arananet/TF-HARDWARE/README.md

# TF-HARDWARE
A backup (04-04-2017) of the last TF repo that includes the projects (TF520,TF530,A3640 & breakout). All the work belongs to Stephen Leary, I just share the files as a repo backup.
