arananet/TF-HARDWARE/tf530/README.md

# TF530

** WARNING THIS IS BETA AT THE MOMENT

This repository contains all the files needed to produce a copy of my accelerator board.

The CPLD Required is a XC9572XL-10VQ64

Everything in this repository is released under the GNU GPLv2. You may create or base commercial PCBs from the work in this repository but you must make the sources for all derivative work available. 

## Firmware / Requirements

  * Xilinx ISE, 14.7 (the final version - other versions may work but this is the one I support)
  * JTAG Adaptor

[For more information visit my channel](https://www.youtube.com/c/TerribleFire)

##License

This project and all the files contained are released under the GNU GPLv2. If you build a modified version of the board you must supply the end user with all the sources (this can be a web link).

##The TerribleFire 530 board (Revision 2)

This board is now in Beta. It may not work in all circumstances but it has been verified to boot AmigaOS 1.3, 2.05 and 3.1 and run various games and desktop apps at 25Mhz. Operation is not guarunteed to be crash free but will work in most "happy path" situations.

I have only verified the HD interface with Compact Flash cards.
I have verified this board boots on Amiga 500 Rev 5, 6a, 8.1a

Revision 3: 

Completely untested board link.... use with caution!!!! Do not come crying to me if it didnt work!!

http://dirtypcbs.com/store/designer/details/12476/2654/tf530-rev3-zip

Revision 2:

To buy 10 blank copies of the revision 2 board follow the following link.

http://dirtypcbs.com/store/designer/details/12476/1330/tf530-rev2b-zip

(Terrible Fire gets a $2 "cut" for each order... in reality this is a downpayment on future prototype board orders).

I accept no responsibiltiy for any damage to any equipment that results from the use of this board. IT IS ENTIRELY AT YOUR OWN RISK!

## Installation

Installation is exactly the same as the Kipper2k A508. Refer to http://www.kipper2k.com/a500fastmem.html

You need to connect the OVR and INT2 signals to the A500 header port. 

## Take this image as example connection

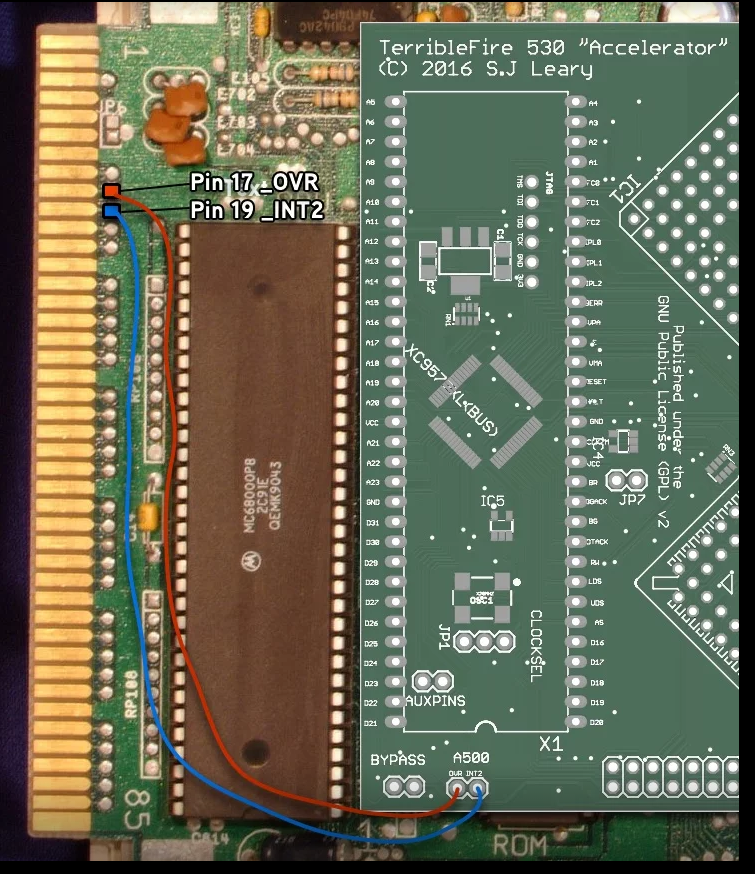
[picture p1: tf530/gerbers/conexion.png]
Connection


## What does the board look like

Rev 3:

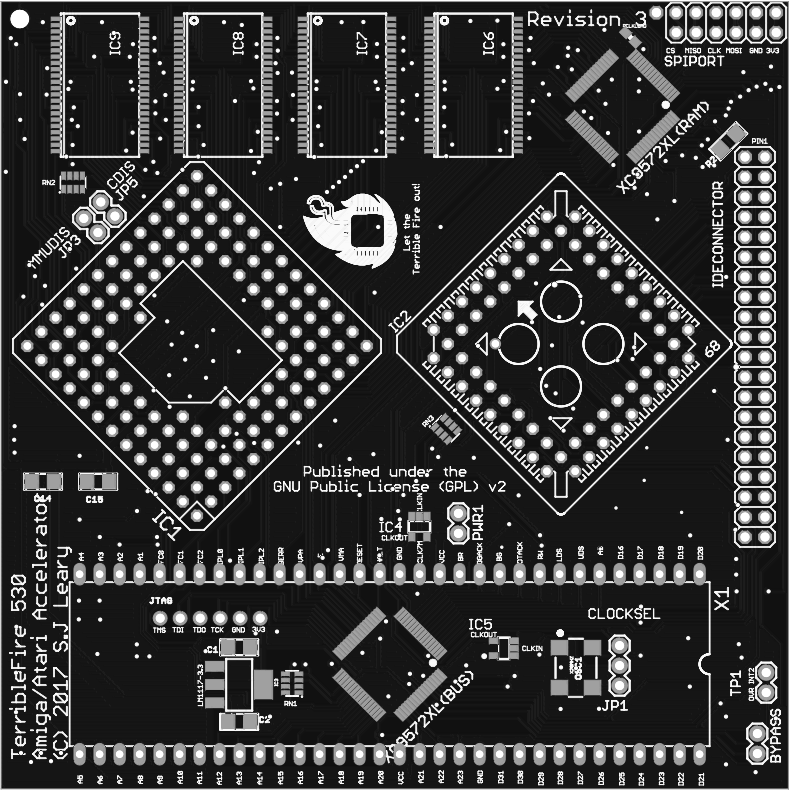
[picture p2: tf530/gerbers/tf530_rev3_top.png]


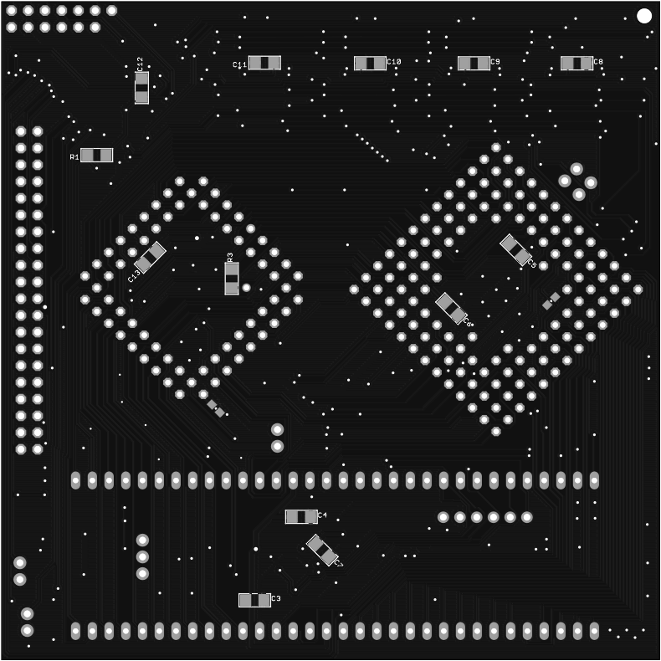
[picture p3: tf530/gerbers/tf530_rev3_bottom.png]
Image of Bottom of PCB


Rev 2:

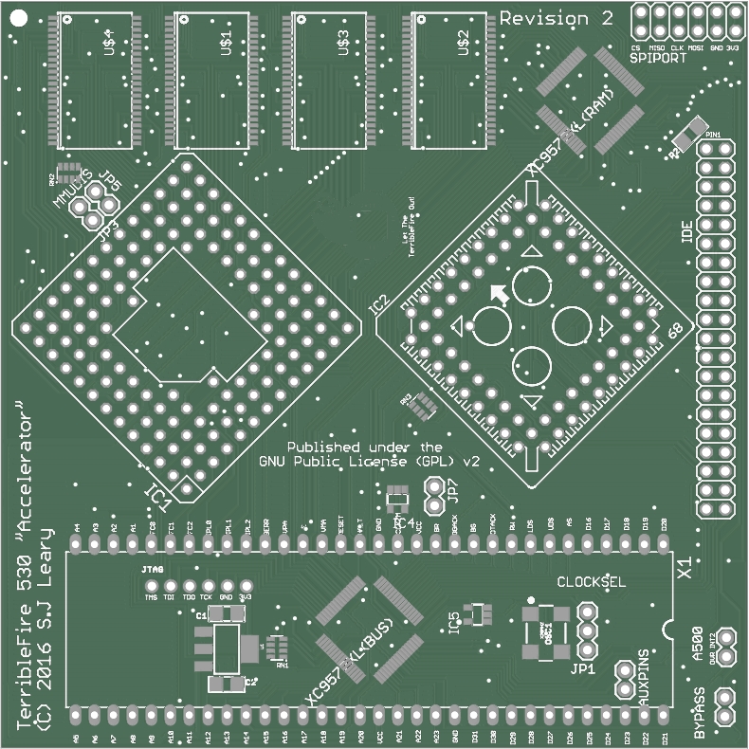
[picture p4: tf530/gerbers/tf530_rev2_top.jpg]


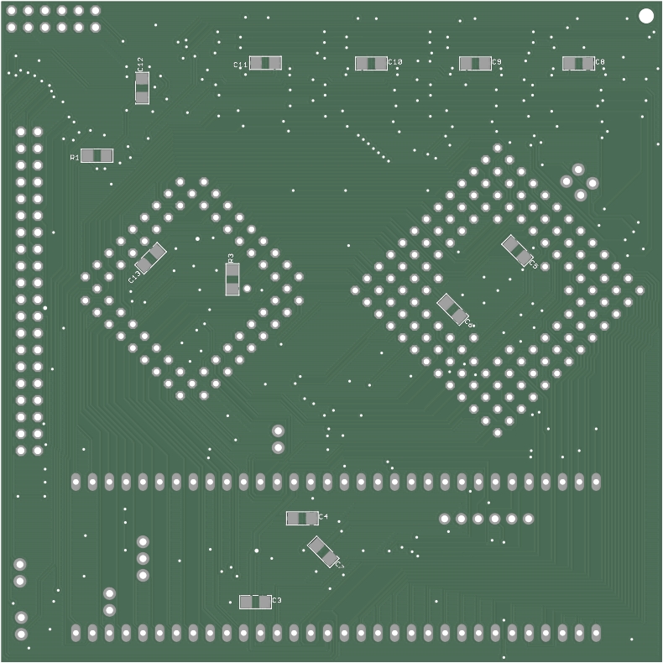
[picture p5: tf530/gerbers/tf530_rev2_bottom.jpg]
Image of Bottom of PCB


## The BOM 

| Qty | Value | Device | Package | Parts | Description | 
|-----|---|---|---|---|---|
| 1 | | MC68030RC | MPGA128 | IC1 | 68xxx PROCESSOR | 
| 1 | | MC68881FN-SOC | PLCC68-S | IC2 | 68xxx PROCESSOR |
| 1 | 10K | RESISTOR1206 | 1206 | R1, R2, R3 | Resistors |
| 13  | 10uF | CAP_CERAMIC1206 | 1206 | C1, C2, C3, C4, C5, C6, C7, C8, C9, C10, C11, C12, C13 | Ceramic Capacitors | 
| 2 | 74LVC1G17DBV | 74LVC1G17DBV | SOT23-5 | IC4, IC5 | Single Schmitt-Trigger Buffer | 
| 1 | A500 | JUMPER-2PTH | 1X02 | A500 | Jumper | 
| 4 | AS7C4096A-12TIN | AS7C4096A-12TCN | TSOP44-II | U$1, U$2, U$3, U$4 | |  
| 1 | AUXPINS | JUMPER-2PTH | 1X02 | AUXPINS | Jumper | 
| 1 | BYPASS | JUMPER-2PTH | 1X02 | BYPASS | Jumper (optional) | 
| 3 | CAY16-103J4LF | CAY16-103J4LF | RESCAXE80P320X160-8N | RN1, RN2, RN3 | Res Thick Film Array 10K Ohm  | 
| 1 | CDIS | JUMPER-2PTH | 1X02 | JP5 | Jumper |
| 1 | CLOCKSEL | JUMPER-3PTH | 1X03 | JP1 | | 
| 1 | EXT5V | JUMPER-2PTH | 1X02 | JP7 | Jumper |
| 1 | IDE CONNECTOR | PINHD-2X20 | 2X20 | IDE | PIN HEADER |
| 1 | JTAG | HEADER-1X6ROUND | 1X06_ROUND | JTAG | PIN HEADER |
| 1 | LM1117 | V_REG_LM1117SOT223 | SOT223 | U1 | 3.3V Voltage  Regulator LM1117 |
| 1 | MC68000 | MC68000P | DIL64 | X1 | 68xxx PROCESSOR SOCKET | 
| 1 | MMUDIS | JUMPER-2PTH | 1X02 | JP3 | Jumper | 
| 1 | SPI PORT | PINHD-2X6 | 2X06 | SPIPORT | PIN HEADER | 
| 1 | X24MHZ | OSCILLATOR | OSC_7X5MM | OSC1 | 24 Mhz llators |
| 2 | XC9572XL-10VQ64 | XC9572XL-VQ64 | VQ64 | XC9572XL(BUS), XC9572XL(RAM) | |
