arananet/TF-HARDWARE/breakout/68kshunt/README.md

# 68k Shunt

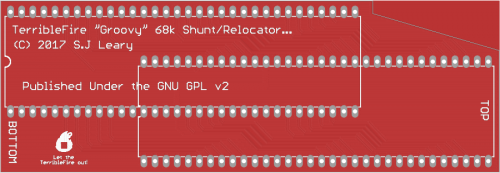
[picture p6: breakout/68kshunt/images/top.png]
Image of Top of PCB
