arananet/TF-HARDWARE/a3640/docs/68040_schematics/68040/68040_0002b.png

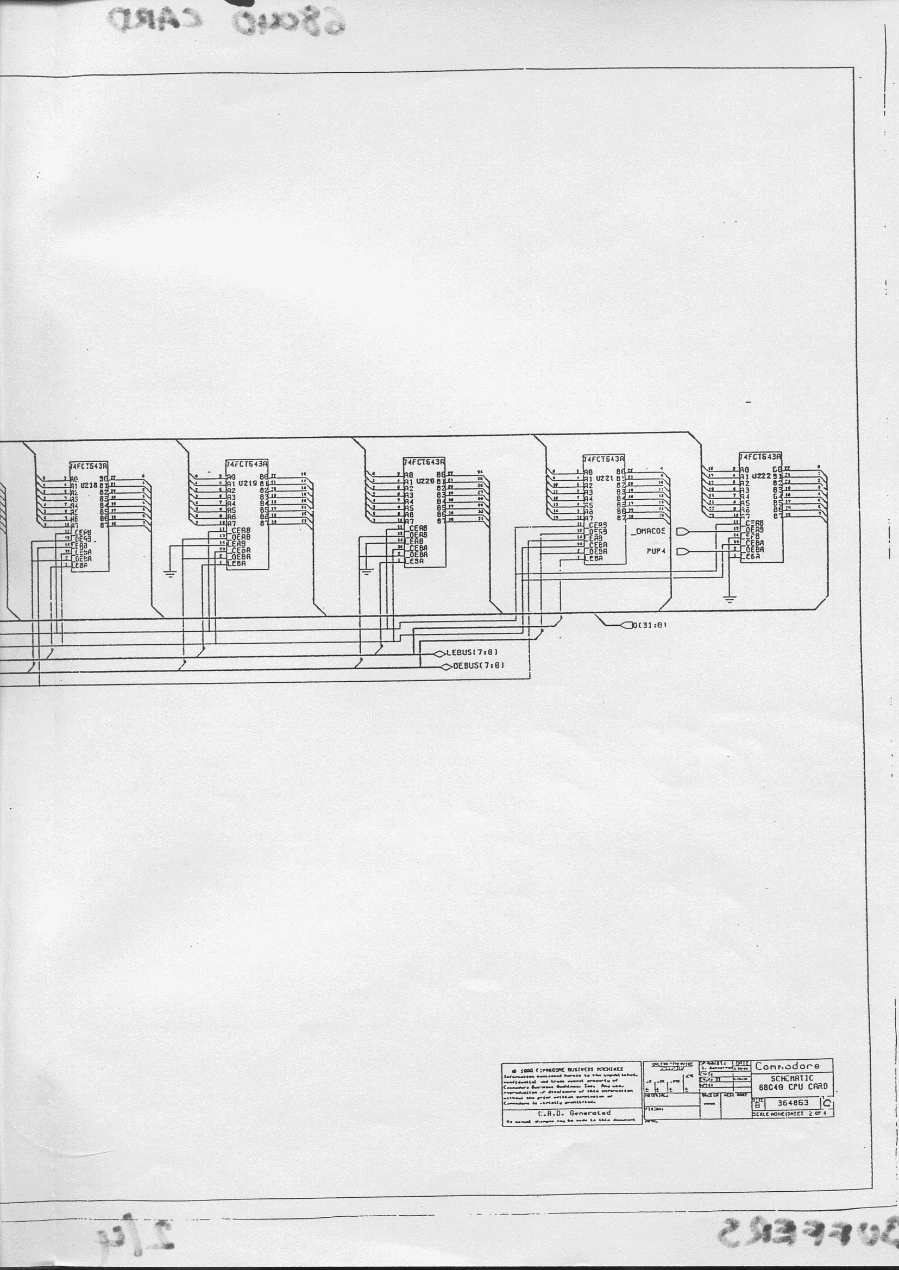
a3640/docs/68040_schematics/68040/68040_0002b.png
