arananet/TF-HARDWARE/breakout/68020/images/bottom.png

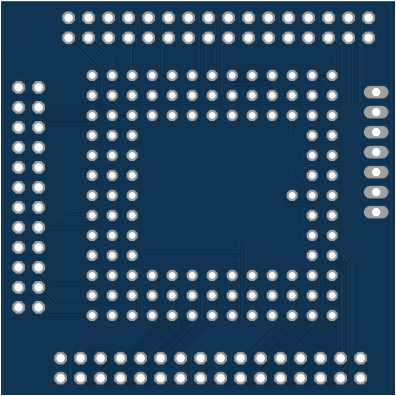
breakout/68020/images/bottom.png
