arananet/TF-HARDWARE/breakout/68020/images/top.png

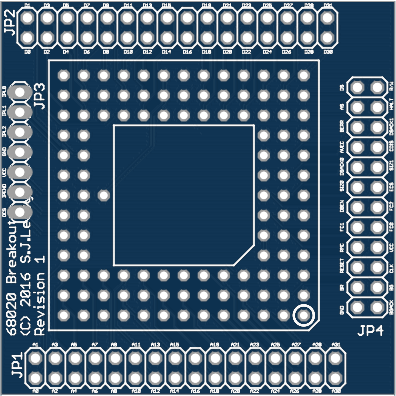
breakout/68020/images/top.png
