arananet/TF-HARDWARE/breakout/68030/images/bottom.png

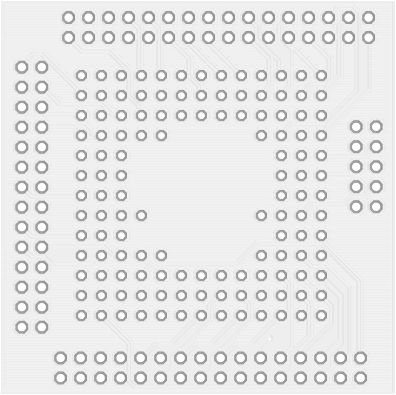
breakout/68030/images/bottom.png
