arananet/TF-HARDWARE/breakout/68030/images/top.png

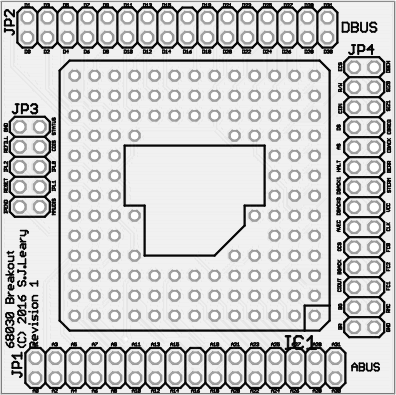
breakout/68030/images/top.png
