arananet/TF-HARDWARE/a3640/docs/a3640_bom.xlsx

Part | Value | Form | Pcb location | Qty. | Mouser | RS | FARNELL | Rocherster | Others
CAPACITOR,SM,X7R | 10nF | 1206 | C100A, | 1 | C1206C103JARACTU
CAPACITOR,SM,Ceramic | 100nF | 1206 | C101A,C103A,C104A,C105A,C200A,C2 01A,C202A,C203A,C204,C205, C206A,C207,C208A,C209,C211, C213,C400A,C401A,C402A, | 19 | C1206C104J5JACTU
CAPACITOR,SM,Z5U | 330nF | 1210 | C101B,C212A,C214A,C215A,C216A,C2 17A,C218A,C219A,C220A,C221A,C222 A, | 11 | C1210C334J3JACTU
CAPACITOR,SM,Z5U | 220nF | 1210 | C102A,C102D, | 2 | C1210C224J3JACTU
CAPACITOR,SM,NPO | 220PF | 1206 | C102C,C102F, | 2 | C1206C221KDRACTU
Cond. ELECTROLYTIC | 22UF | C /16V | C102B,C102E,C105,C106,C107, | 5 | EEH-ZA1V220R
Filter, Ferrit, SMT | 80 Ohm @100Mhz, 500mA | 1812 | FB100,FB200, | 2 | BLM41AF800SN1L
RES Chip, 1/8W, 5% | 1 | 1206 | R100,R103, | 2 | KTR18EZPF1R00
RES Chip, 1/8W, 5% | 22 | 1206 | R101,R102, | 2 | RK73H2BRTTD22R0F
RES Chip, 1/8W, 5% | 33 | 1206 | R107,R108, | 2 | RK73H2BRTTD33R0F
RES Chip, 1/8W, 5% | 100 | 1206 | R401, | 1 | KTR18EZPF1000
RES Chip, 1/8W, 5% | 470 | 1206 | R402,R403,R404, | 3 | KTR18EZPF4700
RES Chip, 1/8W, 5% | 4.7K | 1206 | R104,R105,R106,R405, | 4 | KTR18EZPF4701
RES Chip, 1/8W, 5% | 10K | 1206 | R400, | 1 | KTR18EZPF1002
RPK10 Array 9x | 1K | SIL10 | RP100,RP400,RP401,RP402,RP403,R P404,RP405, | 7 | 4609M-101-102LF
RPK8 Array 4x | 22 | SIL8 | RP101,RP102,RP103,RP104,RP105,R P106,RP107,RP108, | 8 | 4608X-102-220LF
74FCT244AT |  | SO-20 | U402, | 1 | CY74FCT244ATSOC
74FCT374AT |  | SO-20 | U201, | 1 | CY74FCT374ATSOCT
74FCT373AT |  | SO-20 | U200, | 1 | 74FCT373ATSOG
74F32 |  | SO-14 | U202, | 1 | SN74F32D
74F257 |  | SO-16 | U212, | 1 | SN74F257D
74F139 |  | SO-16 | U206, | 1 | 74F139SC
74F04 |  | SO-14 | U105, | 1 | SN74F04DR
7407 |  | SO-14 | U104, | 1 | SN7407DR
74FCT543T |  | SO-24 | U214,U215,U216,U217,U218,U219,U22 0,U221,U222, | 9 | CY74FCT543TSOCT
74F1803 | Clock divider | SO-14 | U101, | 1 |  |  |  |  | Maybe rework circuit
RH5VA43A VoltageDetector |  | SOT-89 | U490, Rework on C400, | 1 | TC54VN2702EMB713
DELAYLINE 5 TAP ea 5ns | 25ns | DIP14 | U103, | 1 |  |  |  | MXD1000SA200
OSC | 50MHz | DIP14/4 | U100, | 1 | MXO45-3C-50M0000
SPJUMPER | SIL 3 |  | J400, | 1
SPJUMPER | SIL 4 |  | J100, | 1
SPJUMPER | SIL 2 |  | TJ100, | 1
Shorting Bars (Shunts) |  |  | 2xJ100,J400,TJ100, | 4
BUS CONNECTOR KEL 817-200-170S-F |  |  | CN100, | 1 |  |  |  |  | Internet
Socket, CPU | 179pin | PGA | U102, | 1 | 510-93-179-18-095002
Head Sink and Clip |  | 47x47 | U102, | 1
MC68040 |  |  | U102, | 1 |  |  |  |  | Internet
GAL 22V10-15 | taxlat | PLCC28 | U213, | 1 | ATF22V10C-15JU(maybe)
GAL 22V10-15 | oebus | PLCC28 | U207, | 1 | ATF22V10C-15JU(maybe)
GAL 22V10-15 | mapper | PLCC28 | U400, | 1 | ATF22V10C-15JU(maybe)
GAL 22V10-10 | buscon | PLCC28 | U204, | 1 | ATF22V10C-15JU(maybe)
GAL 22V10-10 | busterm | PLCC28 | U205, | 1 | ATF22V10C-15JU(maybe)
GAL 22V10-10 | bctl | PLCC28 | U209, | 1 | ATF22V10C-15JU(maybe)
GAL 22V10-10 | start | PLCC28 | U211, | 1 | ATF22V10C-15JU(maybe)
GAL16V8-10 | term | PLCC20 | U203, | 1 | ATF16V8B-10JU(maybe)
GAL16V8-10 | lebus | PLCC20 | U208, | 1 | ATF16V8B-10JU(maybe)
GAL16V8-10 | rst | PLCC20 | U401, | 1 | ATF16V8B-10JU(maybe)
