arananet/TF-HARDWARE/tf530/eagle/SL530.brd

## EAGLE design tf530/eagle/SL530.brd (2017-04-26)

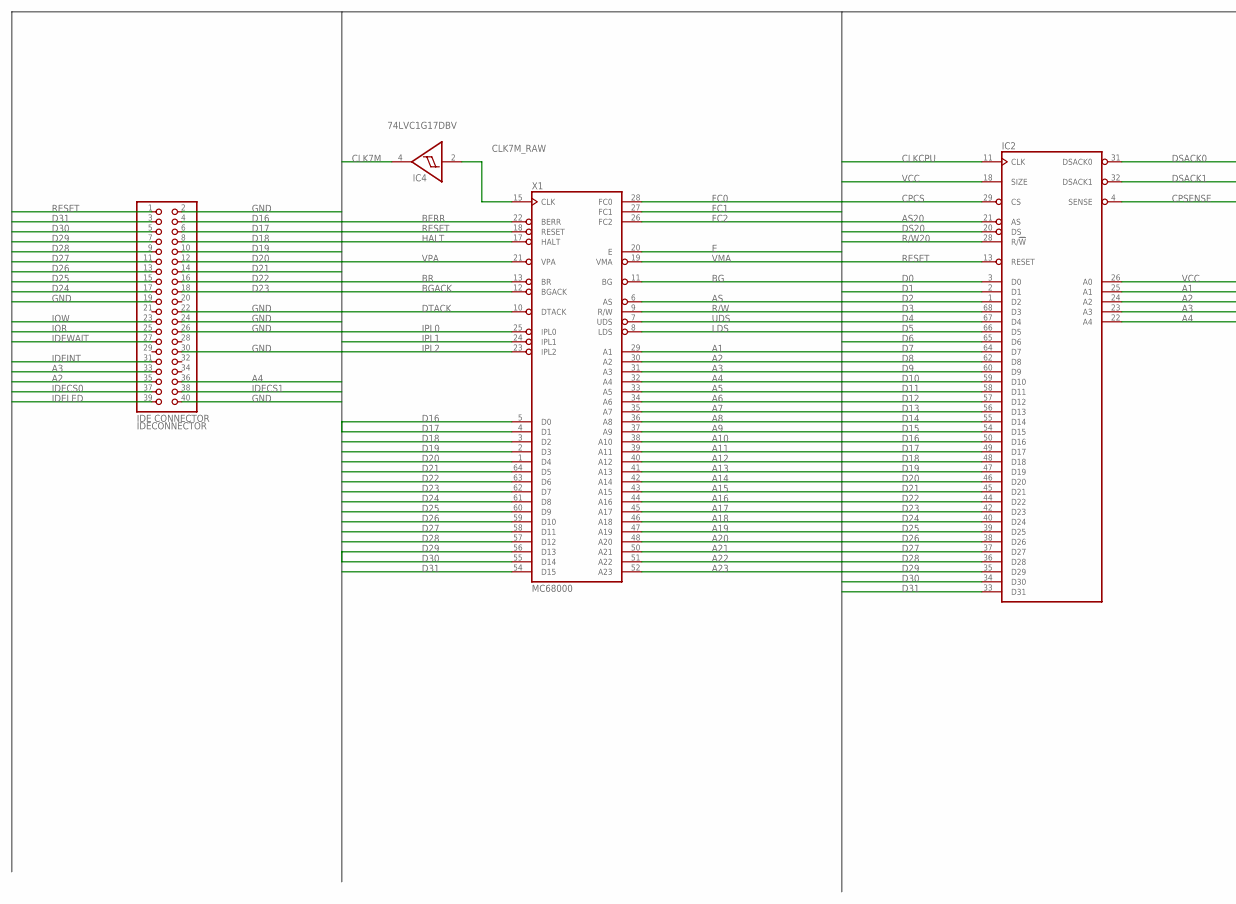
[picture p21: schematic SL530.sch, sheet 1, part in row 1, column 1]

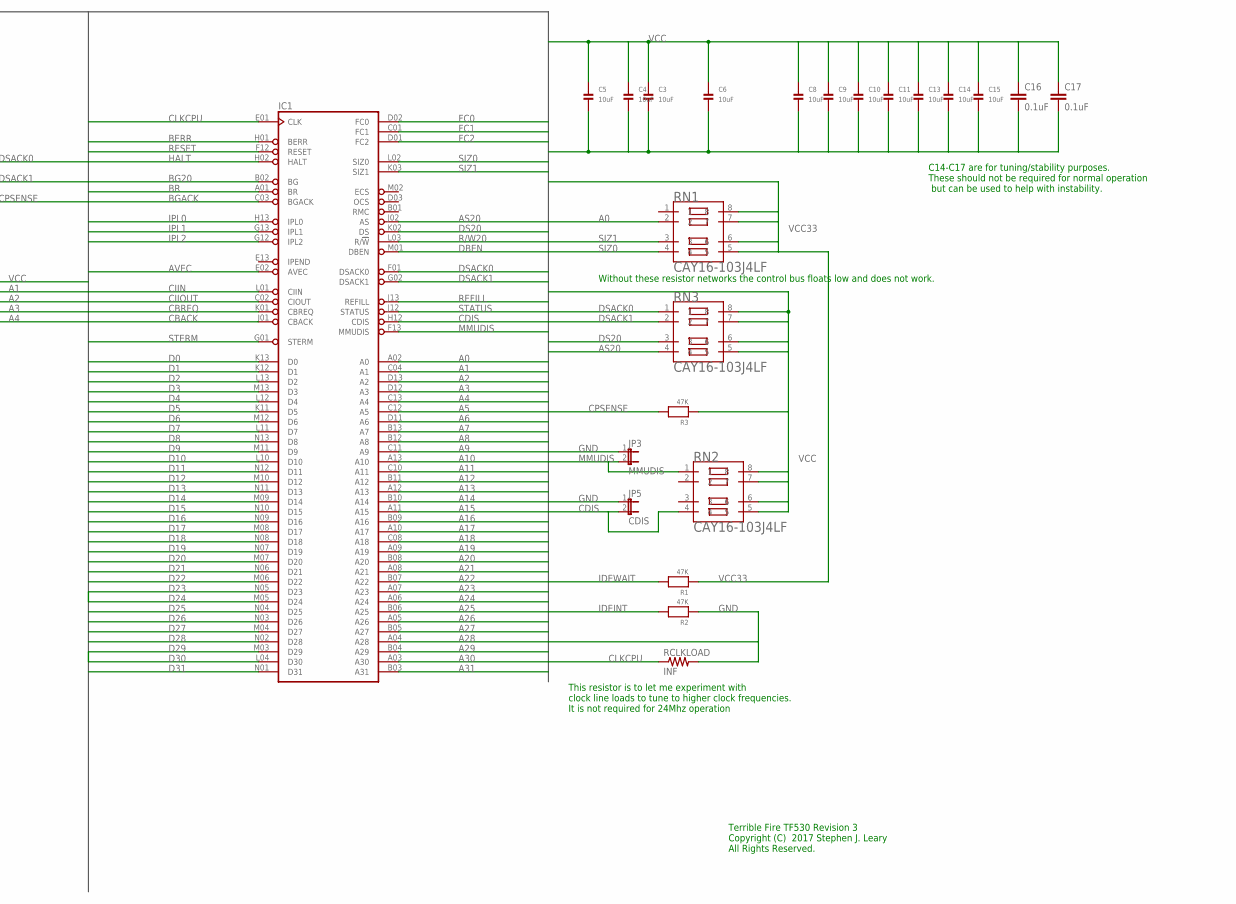
[picture p22: schematic SL530.sch, sheet 1, part in row 1, column 2]

Parts:
C3, C4, C5, C6, C8, C9, C10, C11, C13, C14, C15: 10uF; 1206
C16, C17: 0.1uF; 0603-CAP
IC1: MC68030RC; MPGA128
IC2: MC68881FN-SOC; PLCC68-S
IC4: 74LVC1G17DBV; SOT23-5
IDECONNECTOR: IDE CONNECTOR; 2X20
JP3: MMUDIS; 1X02
JP5: CDIS; 1X02
R1, R2, R3: 47K; 1206
RCLKLOAD: INF; 0603
RN1, RN2, RN3: CAY16-103J4LF; RESCAXE80P320X160-8N
X1: MC68000; DIL64

Connections:
A0: IC1.A02 (A0), RN1.2; also elsewhere on the board
A1: IC1.C04 (A1), IC2.25 (A1), X1.29 (A1); also elsewhere on the board
A2: IC1.D13 (A2), IC2.24 (A2), IDECONNECTOR.35, X1.30 (A2); also elsewhere on the board
A3: IC1.D12 (A3), IC2.23 (A3), IDECONNECTOR.33, X1.31 (A3); also elsewhere on the board
A4: IC1.C13 (A4), IC2.22 (A4), IDECONNECTOR.36, X1.32 (A4); also elsewhere on the board
A5: IC1.C12 (A5), X1.33 (A5); also elsewhere on the board
A6: IC1.D11 (A6), X1.34 (A6); also elsewhere on the board
A7: IC1.B13 (A7), X1.35 (A7); also elsewhere on the board
A8: IC1.B12 (A8), X1.36 (A8); also elsewhere on the board
A9: IC1.C11 (A9), X1.37 (A9); also elsewhere on the board
A10: IC1.A13 (A10), X1.38 (A10); also elsewhere on the board
A11: IC1.C10 (A11), X1.39 (A11); also elsewhere on the board
A12: IC1.B11 (A12), X1.40 (A12); also elsewhere on the board
A13: IC1.A12 (A13), X1.41 (A13); also elsewhere on the board
A14: IC1.B10 (A14), X1.42 (A14); also elsewhere on the board
A15: IC1.A11 (A15), X1.43 (A15); also elsewhere on the board
A16: IC1.B09 (A16), X1.44 (A16); also elsewhere on the board
A17: IC1.A10 (A17), X1.45 (A17); also elsewhere on the board
A18: IC1.C08 (A18), X1.46 (A18); also elsewhere on the board
A19: IC1.A09 (A19), X1.47 (A19); also elsewhere on the board
A20: IC1.B08 (A20), X1.48 (A20); also elsewhere on the board
A21: IC1.A08 (A21), X1.50 (A21); also elsewhere on the board
A22: IC1.B07 (A22), X1.51 (A22); also elsewhere on the board
A23: IC1.A07 (A23), X1.52 (A23); also elsewhere on the board
A24: IC1.A06 (A24)
A25: IC1.B06 (A25)
A26: IC1.A05 (A26)
A27: IC1.B05 (A27)
A28: IC1.A04 (A28)
A29: IC1.B04 (A29)
A30: IC1.A03 (A30)
A31: IC1.B03 (A31)
AS: X1.6 (AS); also elsewhere on the board
AS20: IC1.J02 (AS), IC2.21 (AS), RN3.4; also elsewhere on the board
AVEC: IC1.E02 (AVEC); also elsewhere on the board
BERR: IC1.H01 (BERR), X1.22 (BERR); also elsewhere on the board
BG: X1.11 (BG); also elsewhere on the board
BG20: IC1.B02 (BG); also elsewhere on the board
BGACK: IC1.C03 (BGACK), X1.12 (BGACK); also elsewhere on the board
BR: IC1.A01 (BR), X1.13 (BR)
CBACK: IC1.J01 (CBACK); also elsewhere on the board
CBREQ: IC1.K01 (CBREQ); also elsewhere on the board
CDIS: IC1.H12 (CDIS), JP5.2, RN2.4
CIIN: IC1.L01 (CIIN); also elsewhere on the board
CIIOUT: IC1.C02 (CIOUT)
CLK7M: IC4.4 (O); also elsewhere on the board
CLK7M_RAW: IC4.2 (I), X1.15 (CLK)
CLKCPU: IC1.E01 (CLK), IC2.11 (CLK), RCLKLOAD.1; also elsewhere on the board
CPCS: IC2.29 (CS); also elsewhere on the board
CPSENSE: IC2.4 (SENSE), R3.2; also elsewhere on the board
D0: IC1.K13 (D0), IC2.3 (D0); also elsewhere on the board
D1: IC1.K12 (D1), IC2.2 (D1); also elsewhere on the board
D2: IC1.L13 (D2), IC2.1 (D2); also elsewhere on the board
D3: IC1.M13 (D3), IC2.68 (D3); also elsewhere on the board
D4: IC1.L12 (D4), IC2.67 (D4); also elsewhere on the board
D5: IC1.K11 (D5), IC2.66 (D5); also elsewhere on the board
D6: IC1.M12 (D6), IC2.65 (D6); also elsewhere on the board
D7: IC1.L11 (D7), IC2.64 (D7); also elsewhere on the board
D8: IC1.N13 (D8), IC2.62 (D8); also elsewhere on the board
D9: IC1.M11 (D9), IC2.60 (D9); also elsewhere on the board
D10: IC1.L10 (D10), IC2.59 (D10); also elsewhere on the board
D11: IC1.N12 (D11), IC2.58 (D11); also elsewhere on the board
D12: IC1.M10 (D12), IC2.57 (D12); also elsewhere on the board
D13: IC1.N11 (D13), IC2.56 (D13); also elsewhere on the board
D14: IC1.M09 (D14), IC2.55 (D14); also elsewhere on the board
D15: IC1.N10 (D15), IC2.54 (D15); also elsewhere on the board
D16: IC1.N09 (D16), IC2.50 (D16), IDECONNECTOR.4, X1.5 (D0); also elsewhere on the board
D17: IC1.M08 (D17), IC2.49 (D17), IDECONNECTOR.6, X1.4 (D1); also elsewhere on the board
D18: IC1.N08 (D18), IC2.48 (D18), IDECONNECTOR.8, X1.3 (D2); also elsewhere on the board
D19: IC1.N07 (D19), IC2.47 (D19), IDECONNECTOR.10, X1.2 (D3); also elsewhere on the board
D20: IC1.M07 (D20), IC2.46 (D20), IDECONNECTOR.12, X1.1 (D4); also elsewhere on the board
D21: IC1.N06 (D21), IC2.45 (D21), IDECONNECTOR.14, X1.64 (D5); also elsewhere on the board
D22: IC1.M06 (D22), IC2.44 (D22), IDECONNECTOR.16, X1.63 (D6); also elsewhere on the board
D23: IC1.N05 (D23), IC2.42 (D23), IDECONNECTOR.18, X1.62 (D7); also elsewhere on the board
D24: IC1.M05 (D24), IC2.40 (D24), IDECONNECTOR.17, X1.61 (D8); also elsewhere on the board
D25: IC1.N04 (D25), IC2.39 (D25), IDECONNECTOR.15, X1.60 (D9); also elsewhere on the board
D26: IC1.N03 (D26), IC2.38 (D26), IDECONNECTOR.13, X1.59 (D10); also elsewhere on the board
D27: IC1.M04 (D27), IC2.37 (D27), IDECONNECTOR.11, X1.58 (D11); also elsewhere on the board
D28: IC1.N02 (D28), IC2.36 (D28), IDECONNECTOR.9, X1.57 (D12); also elsewhere on the board
D29: IC1.M03 (D29), IC2.35 (D29), IDECONNECTOR.7, X1.56 (D13); also elsewhere on the board
D30: IC1.L04 (D30), IC2.34 (D30), IDECONNECTOR.5, X1.55 (D14); also elsewhere on the board
D31: IC1.N01 (D31), IC2.33 (D31), IDECONNECTOR.3, X1.54 (D15); also elsewhere on the board
DBEN: IC1.M01 (DBEN)
DS20: IC1.K02 (DS), IC2.20 (DS), RN3.3; also elsewhere on the board
DSACK0: IC1.F01 (DSACK0), IC2.31 (DSACK0), RN3.1
DSACK1: IC1.G02 (DSACK1), IC2.32 (DSACK1), RN3.2; also elsewhere on the board
DTACK: X1.10 (DTACK); also elsewhere on the board
E: X1.20 (E); also elsewhere on the board
FC0: IC1.D02 (FC0), X1.28 (FC0); also elsewhere on the board
FC1: IC1.C01 (FC1), X1.27 (FC1); also elsewhere on the board
FC2: IC1.D01 (FC2), X1.26 (FC2); also elsewhere on the board
GND: C3.2, C4.2, C5.2, C6.2, C8.2, C9.2, C10.2, C11.2, C13.2, C14.2, C15.2, C16.2, C17.2, IC1.C05 (GND), IC1.C07 (GND), IC1.C09 (GND), IC1.E03 (GND), IC1.E11 (GND), IC1.F03 (GND), IC1.G03 (GND), IC1.G11 (GND), IC1.J03 (GND), IC1.J11 (GND), IC1.L05 (GND), IC1.L07 (GND), IC1.L08 (GND), IC1.L09 (GND), IC2.5 (GND), IC2.6 (GND), IC2.7 (GND), IC2.8 (GND), IC2.9 (GND), IC2.12 (GND), IC2.14 (GND), IC2.19 (GND), IC2.30 (GND), IC2.41 (GND), IC2.51 (GND), IC2.63 (GND), IC4.3 (GND), IDECONNECTOR.2, IDECONNECTOR.19, IDECONNECTOR.22, IDECONNECTOR.24, IDECONNECTOR.26, IDECONNECTOR.30, IDECONNECTOR.40, JP3.1, JP5.1, R2.1, RCLKLOAD.2, X1.16 (GND), X1.53 (GND); also elsewhere on the board
HALT: IC1.H02 (HALT), X1.17 (HALT); also elsewhere on the board
IDECS0: IDECONNECTOR.37; also elsewhere on the board
IDECS1: IDECONNECTOR.38; also elsewhere on the board
IDEINT: IDECONNECTOR.31, R2.2; also elsewhere on the board
IDELED: IDECONNECTOR.39
IDEWAIT: IDECONNECTOR.27, R1.2; also elsewhere on the board
IOR: IDECONNECTOR.25; also elsewhere on the board
IOW: IDECONNECTOR.23; also elsewhere on the board
IPL0: IC1.H13 (IPL0), X1.25 (IPL0)
IPL1: IC1.G13 (IPL1), X1.24 (IPL1); also elsewhere on the board
IPL2: IC1.G12 (IPL2), X1.23 (IPL2); also elsewhere on the board
LDS: X1.8 (LDS); also elsewhere on the board
MMUDIS: IC1.F13 (MMUDIS), JP3.2, RN2.1
R/W: X1.9 (R/W); also elsewhere on the board
R/W20: IC1.L03 (R/!W), IC2.28 (R/!W); also elsewhere on the board
REFILL: IC1.J13 (REFILL)
RESET: IC1.F12 (RESET), IC2.13 (RESET), IDECONNECTOR.1, X1.18 (RESET); also elsewhere on the board
SIZ0: IC1.L02 (SIZ0), RN1.4; also elsewhere on the board
SIZ1: IC1.K03 (SIZ1), RN1.3; also elsewhere on the board
STATUS: IC1.J12 (STATUS)
STERM: IC1.G01 (STERM); also elsewhere on the board
UDS: X1.7 (UDS); also elsewhere on the board
VCC: C3.1, C4.1, C5.1, C6.1, C8.1, C9.1, C10.1, C11.1, C13.1, C14.1, C15.1, C16.1, C17.1, IC1.C06 (VCC), IC1.D04 (VCC), IC1.D10 (VCC), IC1.F02 (VCC), IC1.F11 (VCC), IC1.H03 (VCC), IC1.H11 (VCC), IC1.K04 (VCC), IC1.K10 (VCC), IC1.L06 (VCC), IC2.10 (VCC), IC2.16 (VCC), IC2.17 (VCC), IC2.18 (SIZE), IC2.26 (A0), IC2.27 (VCC), IC2.43 (VCC), IC2.52 (VCC), IC2.53 (VCC), IC2.61 (VCC), IC4.5 (VCC), R3.1, RN2.5, RN2.6, RN2.7, RN2.8, RN3.5, RN3.6, RN3.7, RN3.8, X1.14 (VCC), X1.49 (VCC); also elsewhere on the board
VCC33: R1.1, RN1.5, RN1.6, RN1.7, RN1.8; also elsewhere on the board
VMA: X1.19 (VMA); also elsewhere on the board
VPA: X1.21 (VPA); also elsewhere on the board

Notes on the sheet:
This resistor is to let me experiment with clock line loads to tune to higher clock frequencies. It is not required for 24Mhz operation
C14-C17 are for tuning/stability purposes. These should not be required for normal operation but can be used to help with instability.
Without these resistor networks the control bus floats low and does not work.
Terrible Fire TF530 Revision 3 Copyright (C) 2017 Stephen J. Leary All Rights Reserved.

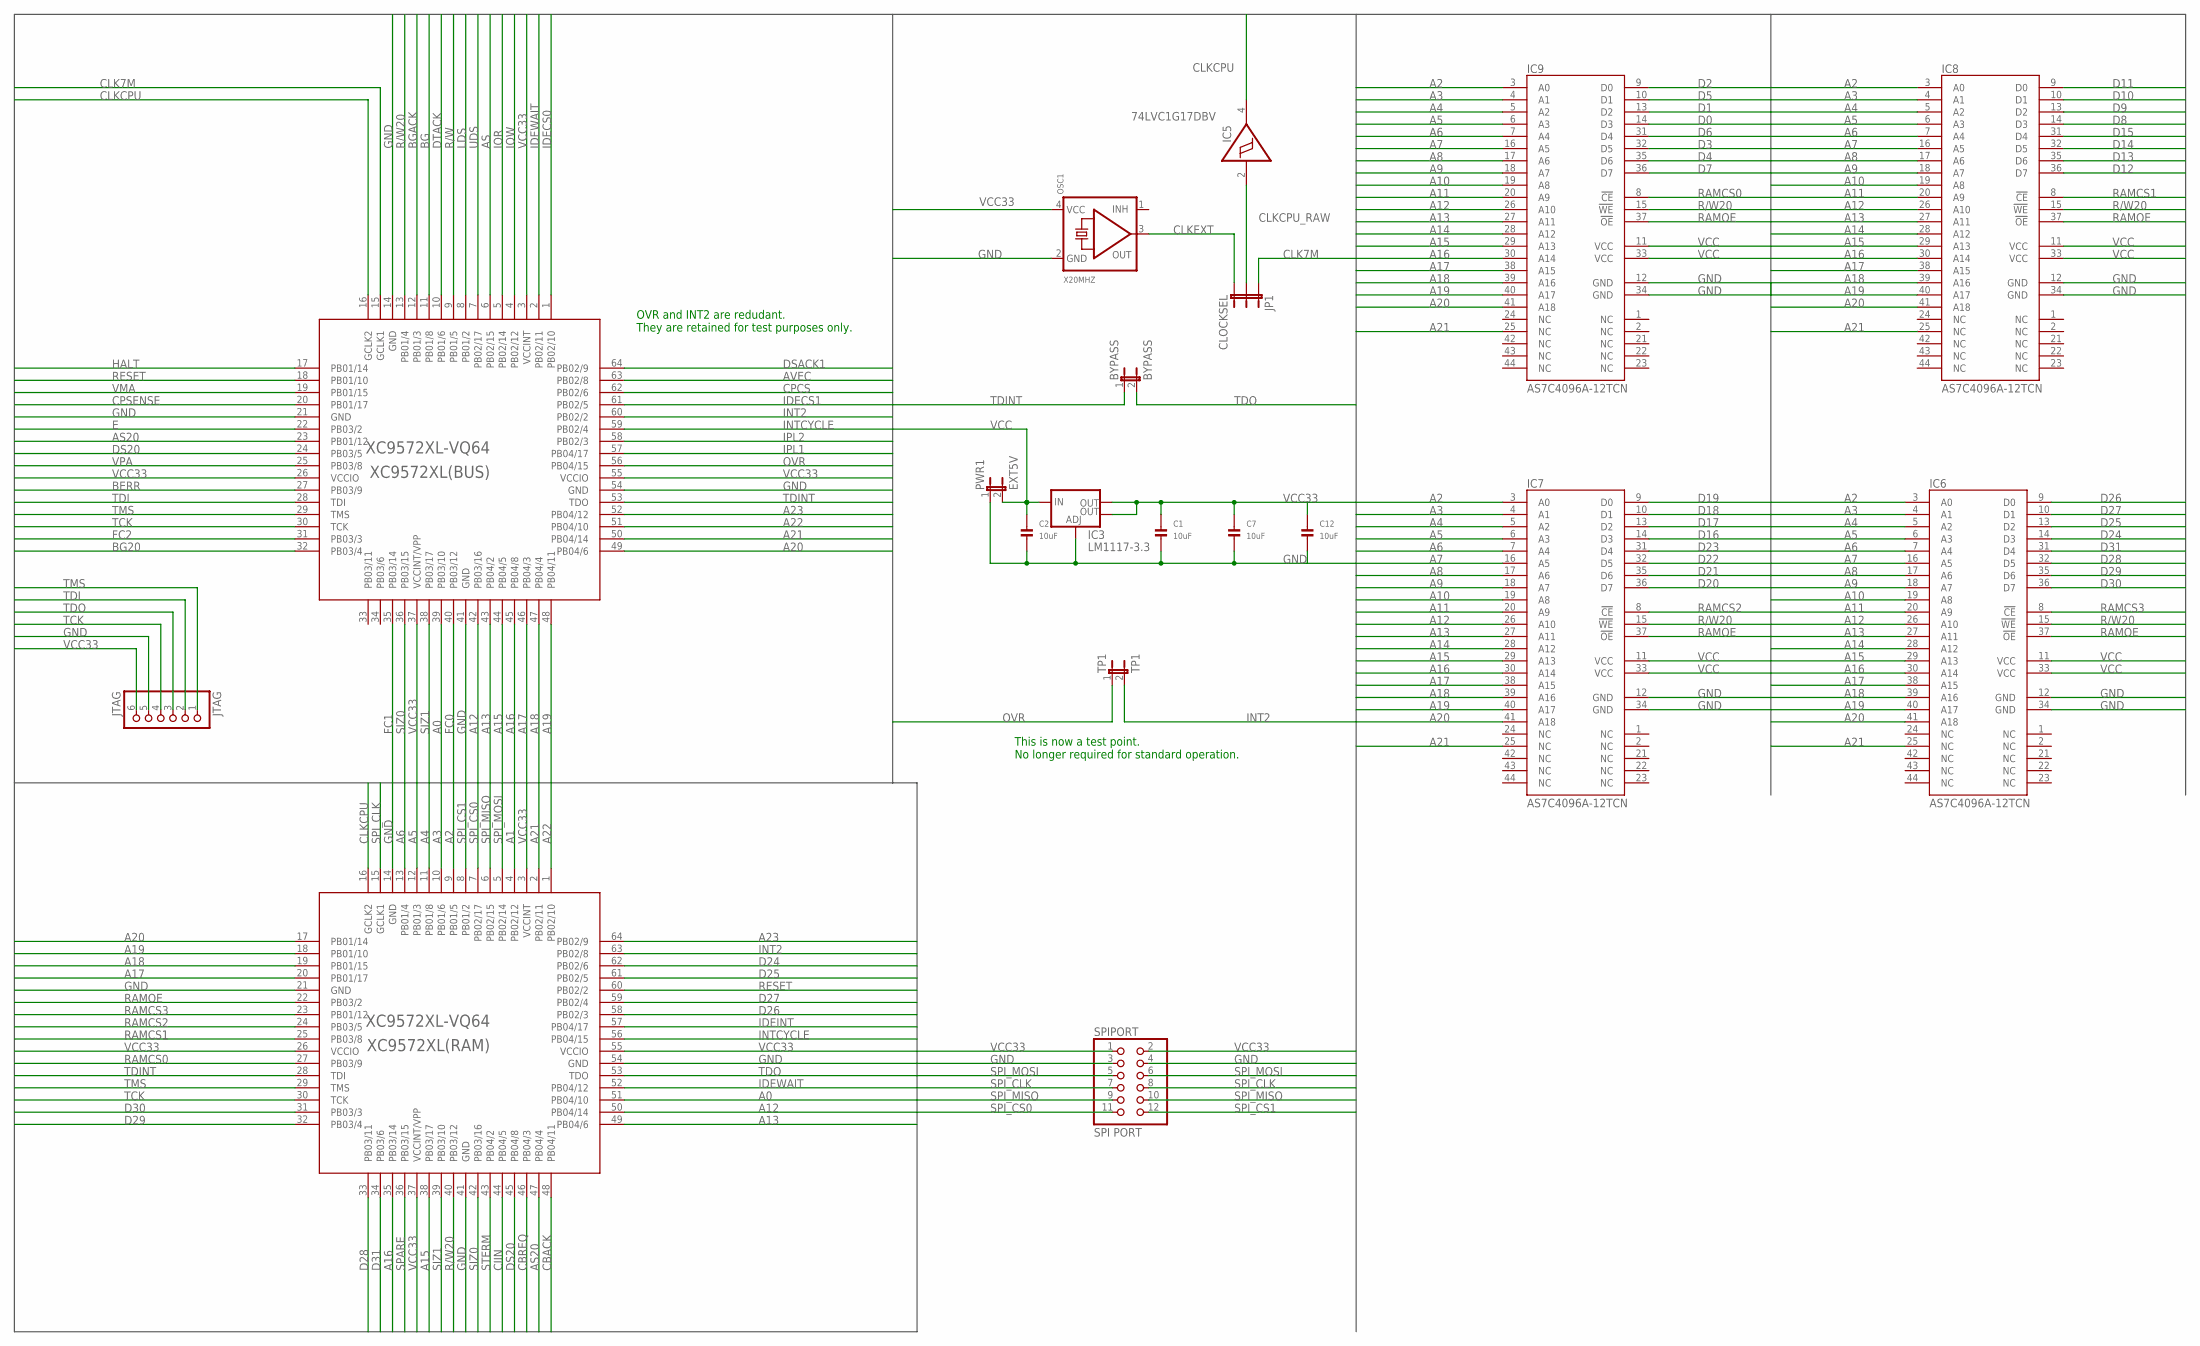
[picture p23: schematic SL530.sch, sheet 2]

Parts:
BYPASS: BYPASS; 1X02
C1, C2, C7, C12: 10uF; 1206
IC3: LM1117-3.3; SOT223
IC5: 74LVC1G17DBV; SOT23-5
IC6, IC7, IC8, IC9: AS7C4096A-12TCN; TSOP44-II
JP1: CLOCKSEL; 1X03
JTAG: JTAG; 1X06_ROUND
OSC1: X20MHZ; OSC_7X5MM
PWR1: EXT5V; 1X02
SPIPORT: SPI PORT; 2X06
TP1: TP1; 1X02
XC9572XL(BUS), XC9572XL(RAM): XC9572XL-VQ64; VQ64

Connections:
A0: XC9572XL(BUS).39 (PB03/10), XC9572XL(RAM).51 (PB04/10); also elsewhere on the board
A1: XC9572XL(RAM).4 (PB02/12); also elsewhere on the board
A2: IC6.3 (A0), IC7.3 (A0), IC8.3 (A0), IC9.3 (A0), XC9572XL(RAM).9 (PB01/5); also elsewhere on the board
A3: IC6.4 (A1), IC7.4 (A1), IC8.4 (A1), IC9.4 (A1), XC9572XL(RAM).10 (PB01/6); also elsewhere on the board
A4: IC6.5 (A2), IC7.5 (A2), IC8.5 (A2), IC9.5 (A2), XC9572XL(RAM).11 (PB01/8); also elsewhere on the board
A5: IC6.6 (A3), IC7.6 (A3), IC8.6 (A3), IC9.6 (A3), XC9572XL(RAM).12 (PB01/3); also elsewhere on the board
A6: IC6.7 (A4), IC7.7 (A4), IC8.7 (A4), IC9.7 (A4), XC9572XL(RAM).13 (PB01/4); also elsewhere on the board
A7: IC6.16 (A5), IC7.16 (A5), IC8.16 (A5), IC9.16 (A5); also elsewhere on the board
A8: IC6.17 (A6), IC7.17 (A6), IC8.17 (A6), IC9.17 (A6); also elsewhere on the board
A9: IC6.18 (A7), IC7.18 (A7), IC8.18 (A7), IC9.18 (A7); also elsewhere on the board
A10: IC6.19 (A8), IC7.19 (A8), IC8.19 (A8), IC9.19 (A8); also elsewhere on the board
A11: IC6.20 (A9), IC7.20 (A9), IC8.20 (A9), IC9.20 (A9); also elsewhere on the board
A12: IC6.26 (A10), IC7.26 (A10), IC8.26 (A10), IC9.26 (A10), XC9572XL(BUS).42 (PB03/16), XC9572XL(RAM).50 (PB04/14); also elsewhere on the board
A13: IC6.27 (A11), IC7.27 (A11), IC8.27 (A11), IC9.27 (A11), XC9572XL(BUS).43 (PB04/2), XC9572XL(RAM).49 (PB04/6); also elsewhere on the board
A14: IC6.28 (A12), IC7.28 (A12), IC8.28 (A12), IC9.28 (A12); also elsewhere on the board
A15: IC6.29 (A13), IC7.29 (A13), IC8.29 (A13), IC9.29 (A13), XC9572XL(BUS).44 (PB04/5), XC9572XL(RAM).38 (PB03/17); also elsewhere on the board
A16: IC6.30 (A14), IC7.30 (A14), IC8.30 (A14), IC9.30 (A14), XC9572XL(BUS).45 (PB04/8), XC9572XL(RAM).35 (PB03/14); also elsewhere on the board
A17: IC6.38 (A15), IC7.38 (A15), IC8.38 (A15), IC9.38 (A15), XC9572XL(BUS).46 (PB04/3), XC9572XL(RAM).20 (PB01/17); also elsewhere on the board
A18: IC6.39 (A16), IC7.39 (A16), IC8.39 (A16), IC9.39 (A16), XC9572XL(BUS).47 (PB04/4), XC9572XL(RAM).19 (PB01/15); also elsewhere on the board
A19: IC6.40 (A17), IC7.40 (A17), IC8.40 (A17), IC9.40 (A17), XC9572XL(BUS).48 (PB04/11), XC9572XL(RAM).18 (PB01/10); also elsewhere on the board
A20: IC6.41 (A18), IC7.41 (A18), IC8.41 (A18), IC9.41 (A18), XC9572XL(BUS).49 (PB04/6), XC9572XL(RAM).17 (PB01/14); also elsewhere on the board
A21: IC6.25 (NC), IC7.25 (NC), IC8.25 (NC), IC9.25 (NC), XC9572XL(BUS).50 (PB04/14), XC9572XL(RAM).2 (PB02/11); also elsewhere on the board
A22: XC9572XL(BUS).51 (PB04/10), XC9572XL(RAM).1 (PB02/10); also elsewhere on the board
A23: XC9572XL(BUS).52 (PB04/12), XC9572XL(RAM).64 (PB02/9); also elsewhere on the board
AS: XC9572XL(BUS).6 (PB02/15); also elsewhere on the board
AS20: XC9572XL(BUS).23 (PB01/12), XC9572XL(RAM).47 (PB04/4); also elsewhere on the board
AVEC: XC9572XL(BUS).63 (PB02/8); also elsewhere on the board
BERR: XC9572XL(BUS).27 (PB03/9); also elsewhere on the board
BG: XC9572XL(BUS).11 (PB01/8); also elsewhere on the board
BG20: XC9572XL(BUS).32 (PB03/4); also elsewhere on the board
BGACK: XC9572XL(BUS).12 (PB01/3); also elsewhere on the board
CBACK: XC9572XL(RAM).48 (PB04/11); also elsewhere on the board
CBREQ: XC9572XL(RAM).46 (PB04/3); also elsewhere on the board
CIIN: XC9572XL(RAM).44 (PB04/5); also elsewhere on the board
CLK7M: JP1.1, XC9572XL(BUS).15 (GCLK1); also elsewhere on the board
CLKCPU: IC5.4 (O), XC9572XL(BUS).16 (GCLK2), XC9572XL(RAM).16 (GCLK2); also elsewhere on the board
CLKCPU_RAW: IC5.2 (I), JP1.2
CLKEXT: JP1.3, OSC1.3 (OUT)
CPCS: XC9572XL(BUS).62 (PB02/6); also elsewhere on the board
CPSENSE: XC9572XL(BUS).20 (PB01/17); also elsewhere on the board
D0: IC9.14 (D3); also elsewhere on the board
D1: IC9.13 (D2); also elsewhere on the board
D2: IC9.9 (D0); also elsewhere on the board
D3: IC9.32 (D5); also elsewhere on the board
D4: IC9.35 (D6); also elsewhere on the board
D5: IC9.10 (D1); also elsewhere on the board
D6: IC9.31 (D4); also elsewhere on the board
D7: IC9.36 (D7); also elsewhere on the board
D8: IC8.14 (D3); also elsewhere on the board
D9: IC8.13 (D2); also elsewhere on the board
D10: IC8.10 (D1); also elsewhere on the board
D11: IC8.9 (D0); also elsewhere on the board
D12: IC8.36 (D7); also elsewhere on the board
D13: IC8.35 (D6); also elsewhere on the board
D14: IC8.32 (D5); also elsewhere on the board
D15: IC8.31 (D4); also elsewhere on the board
D16: IC7.14 (D3); also elsewhere on the board
D17: IC7.13 (D2); also elsewhere on the board
D18: IC7.10 (D1); also elsewhere on the board
D19: IC7.9 (D0); also elsewhere on the board
D20: IC7.36 (D7); also elsewhere on the board
D21: IC7.35 (D6); also elsewhere on the board
D22: IC7.32 (D5); also elsewhere on the board
D23: IC7.31 (D4); also elsewhere on the board
D24: IC6.14 (D3), XC9572XL(RAM).62 (PB02/6); also elsewhere on the board
D25: IC6.13 (D2), XC9572XL(RAM).61 (PB02/5); also elsewhere on the board
D26: IC6.9 (D0), XC9572XL(RAM).58 (PB02/3); also elsewhere on the board
D27: IC6.10 (D1), XC9572XL(RAM).59 (PB02/4); also elsewhere on the board
D28: IC6.32 (D5), XC9572XL(RAM).33 (PB03/11); also elsewhere on the board
D29: IC6.35 (D6), XC9572XL(RAM).32 (PB03/4); also elsewhere on the board
D30: IC6.36 (D7), XC9572XL(RAM).31 (PB03/3); also elsewhere on the board
D31: IC6.31 (D4), XC9572XL(RAM).34 (PB03/6); also elsewhere on the board
DS20: XC9572XL(BUS).24 (PB03/5), XC9572XL(RAM).45 (PB04/8); also elsewhere on the board
DSACK1: XC9572XL(BUS).64 (PB02/9); also elsewhere on the board
DTACK: XC9572XL(BUS).10 (PB01/6); also elsewhere on the board
E: XC9572XL(BUS).22 (PB03/2); also elsewhere on the board
FC0: XC9572XL(BUS).40 (PB03/12); also elsewhere on the board
FC1: XC9572XL(BUS).35 (PB03/14); also elsewhere on the board
FC2: XC9572XL(BUS).31 (PB03/3); also elsewhere on the board
GND: C1.2, C2.2, C7.2, C12.2, IC3.1 (ADJ), IC5.3 (GND), IC6.12 (GND), IC6.34 (GND), IC7.12 (GND), IC7.34 (GND), IC8.12 (GND), IC8.34 (GND), IC9.12 (GND), IC9.34 (GND), JTAG.5, OSC1.2 (GND), PWR1.1, SPIPORT.3, SPIPORT.4, XC9572XL(BUS).14 (GND), XC9572XL(BUS).21 (GND), XC9572XL(BUS).41 (GND), XC9572XL(BUS).54 (GND), XC9572XL(RAM).14 (GND), XC9572XL(RAM).21 (GND), XC9572XL(RAM).41 (GND), XC9572XL(RAM).54 (GND); also elsewhere on the board
HALT: XC9572XL(BUS).17 (PB01/14); also elsewhere on the board
IDECS0: XC9572XL(BUS).1 (PB02/10); also elsewhere on the board
IDECS1: XC9572XL(BUS).61 (PB02/5); also elsewhere on the board
IDEINT: XC9572XL(RAM).57 (PB04/17); also elsewhere on the board
IDEWAIT: XC9572XL(BUS).2 (PB02/11), XC9572XL(RAM).52 (PB04/12); also elsewhere on the board
INT2: TP1.2, XC9572XL(BUS).60 (PB02/2), XC9572XL(RAM).63 (PB02/8)
INTCYCLE: XC9572XL(BUS).59 (PB02/4), XC9572XL(RAM).56 (PB04/15)
IOR: XC9572XL(BUS).5 (PB02/14); also elsewhere on the board
IOW: XC9572XL(BUS).4 (PB02/12); also elsewhere on the board
IPL1: XC9572XL(BUS).57 (PB04/17); also elsewhere on the board
IPL2: XC9572XL(BUS).58 (PB02/3); also elsewhere on the board
LDS: XC9572XL(BUS).8 (PB01/2); also elsewhere on the board
OVR: TP1.1, XC9572XL(BUS).56 (PB04/15)
R/W: XC9572XL(BUS).9 (PB01/5); also elsewhere on the board
R/W20: IC6.15 (!WE), IC7.15 (!WE), IC8.15 (!WE), IC9.15 (!WE), XC9572XL(BUS).13 (PB01/4), XC9572XL(RAM).40 (PB03/12); also elsewhere on the board
RAMCS0: IC9.8 (!CE), XC9572XL(RAM).27 (PB03/9)
RAMCS1: IC8.8 (!CE), XC9572XL(RAM).25 (PB03/8)
RAMCS2: IC7.8 (!CE), XC9572XL(RAM).24 (PB03/5)
RAMCS3: IC6.8 (!CE), XC9572XL(RAM).23 (PB01/12)
RAMOE: IC6.37 (!OE), IC7.37 (!OE), IC8.37 (!OE), IC9.37 (!OE), XC9572XL(RAM).22 (PB03/2)
RESET: XC9572XL(BUS).18 (PB01/10), XC9572XL(RAM).60 (PB02/2); also elsewhere on the board
SIZ0: XC9572XL(BUS).36 (PB03/15), XC9572XL(RAM).42 (PB03/16); also elsewhere on the board
SIZ1: XC9572XL(BUS).38 (PB03/17), XC9572XL(RAM).39 (PB03/10); also elsewhere on the board
SPARE: XC9572XL(RAM).36 (PB03/15)
SPI_CLK: SPIPORT.7, SPIPORT.8, XC9572XL(RAM).15 (GCLK1)
SPI_CS0: SPIPORT.11, XC9572XL(RAM).7 (PB02/17)
SPI_CS1: SPIPORT.12, XC9572XL(RAM).8 (PB01/2)
SPI_MISO: SPIPORT.9, SPIPORT.10, XC9572XL(RAM).6 (PB02/15)
SPI_MOSI: SPIPORT.5, SPIPORT.6, XC9572XL(RAM).5 (PB02/14)
STERM: XC9572XL(RAM).43 (PB04/2); also elsewhere on the board
TCK: JTAG.4, XC9572XL(BUS).30 (TCK), XC9572XL(RAM).30 (TCK)
TDI: JTAG.2, XC9572XL(BUS).28 (TDI)
TDINT: BYPASS.1, XC9572XL(BUS).53 (TDO), XC9572XL(RAM).28 (TDI)
TDO: BYPASS.2, JTAG.3, XC9572XL(RAM).53 (TDO)
TMS: JTAG.1, XC9572XL(BUS).29 (TMS), XC9572XL(RAM).29 (TMS)
UDS: XC9572XL(BUS).7 (PB02/17); also elsewhere on the board
VCC: C2.1, IC3.3 (IN), IC5.5 (VCC), IC6.11 (VCC), IC6.33 (VCC), IC7.11 (VCC), IC7.33 (VCC), IC8.11 (VCC), IC8.33 (VCC), IC9.11 (VCC), IC9.33 (VCC), PWR1.2; also elsewhere on the board
VCC33: C1.1, C7.1, C12.1, IC3.2 (OUT), IC3.4 (OUT), JTAG.6, OSC1.4 (VCC), SPIPORT.1, SPIPORT.2, XC9572XL(BUS).3 (VCCINT), XC9572XL(BUS).26 (VCCIO), XC9572XL(BUS).37 (VCCINT/VPP), XC9572XL(BUS).55 (VCCIO), XC9572XL(RAM).3 (VCCINT), XC9572XL(RAM).26 (VCCIO), XC9572XL(RAM).37 (VCCINT/VPP), XC9572XL(RAM).55 (VCCIO); also elsewhere on the board
VMA: XC9572XL(BUS).19 (PB01/15); also elsewhere on the board
VPA: XC9572XL(BUS).25 (PB03/8); also elsewhere on the board

Notes on the sheet:
OVR and INT2 are redudant. They are retained for test purposes only.
This is now a test point. No longer required for standard operation.

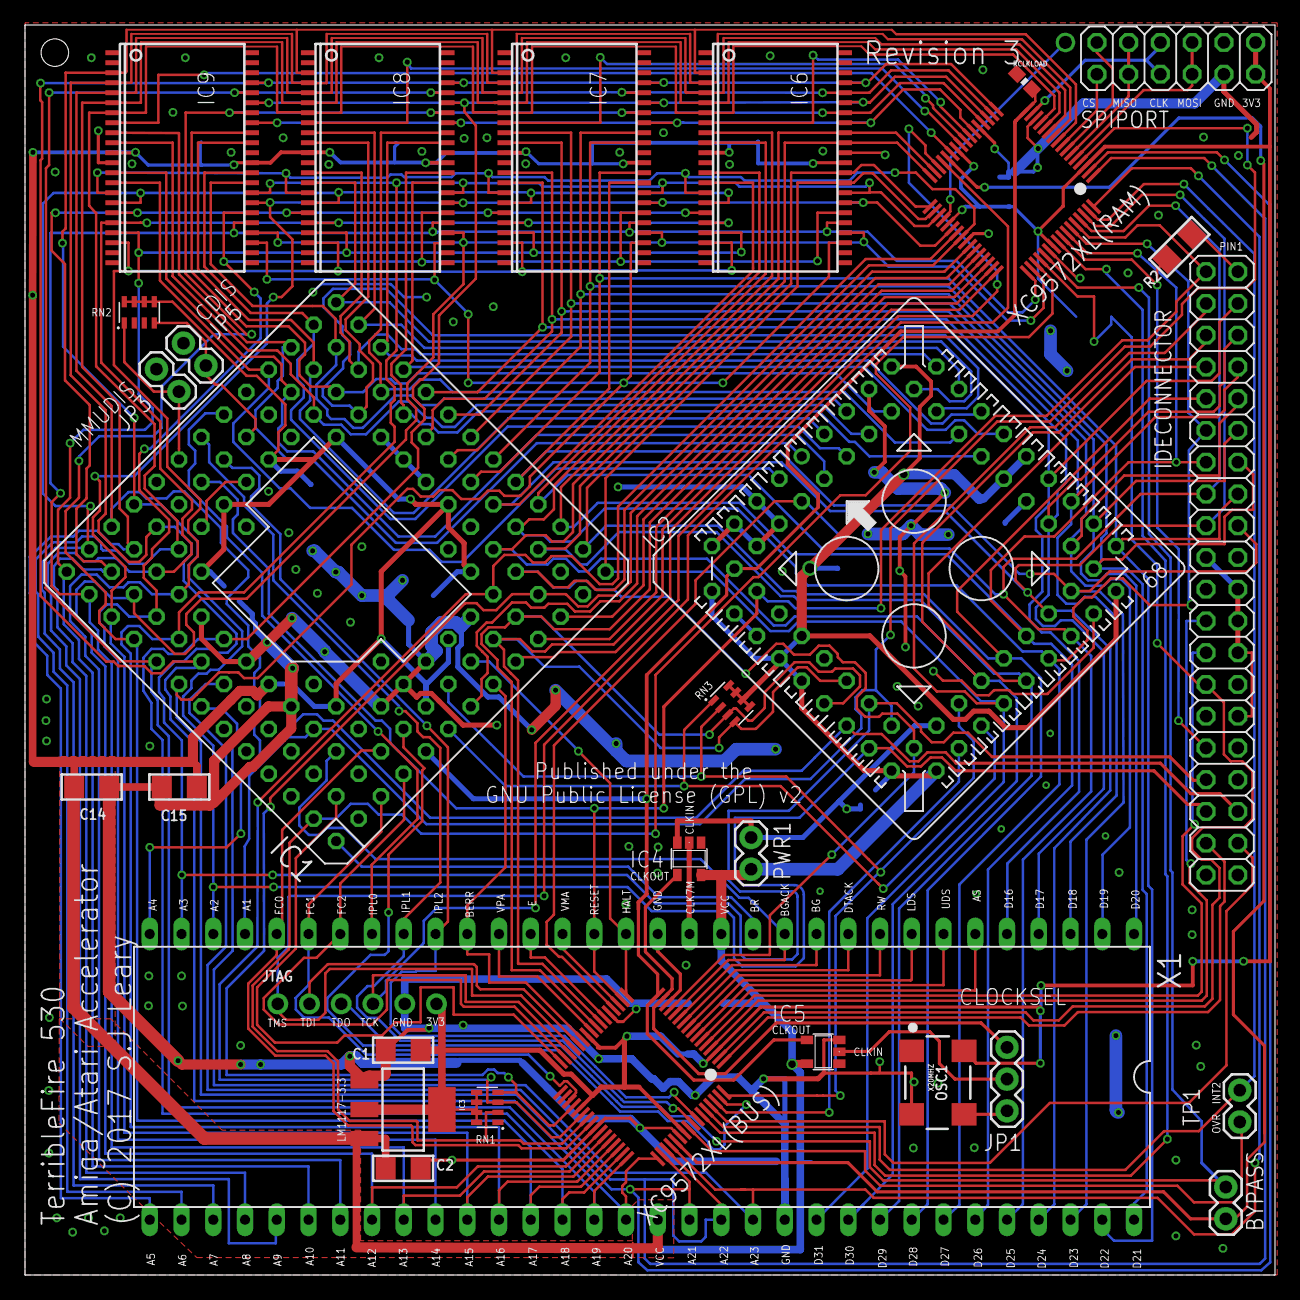
[picture p24: board SL530.brd from above]

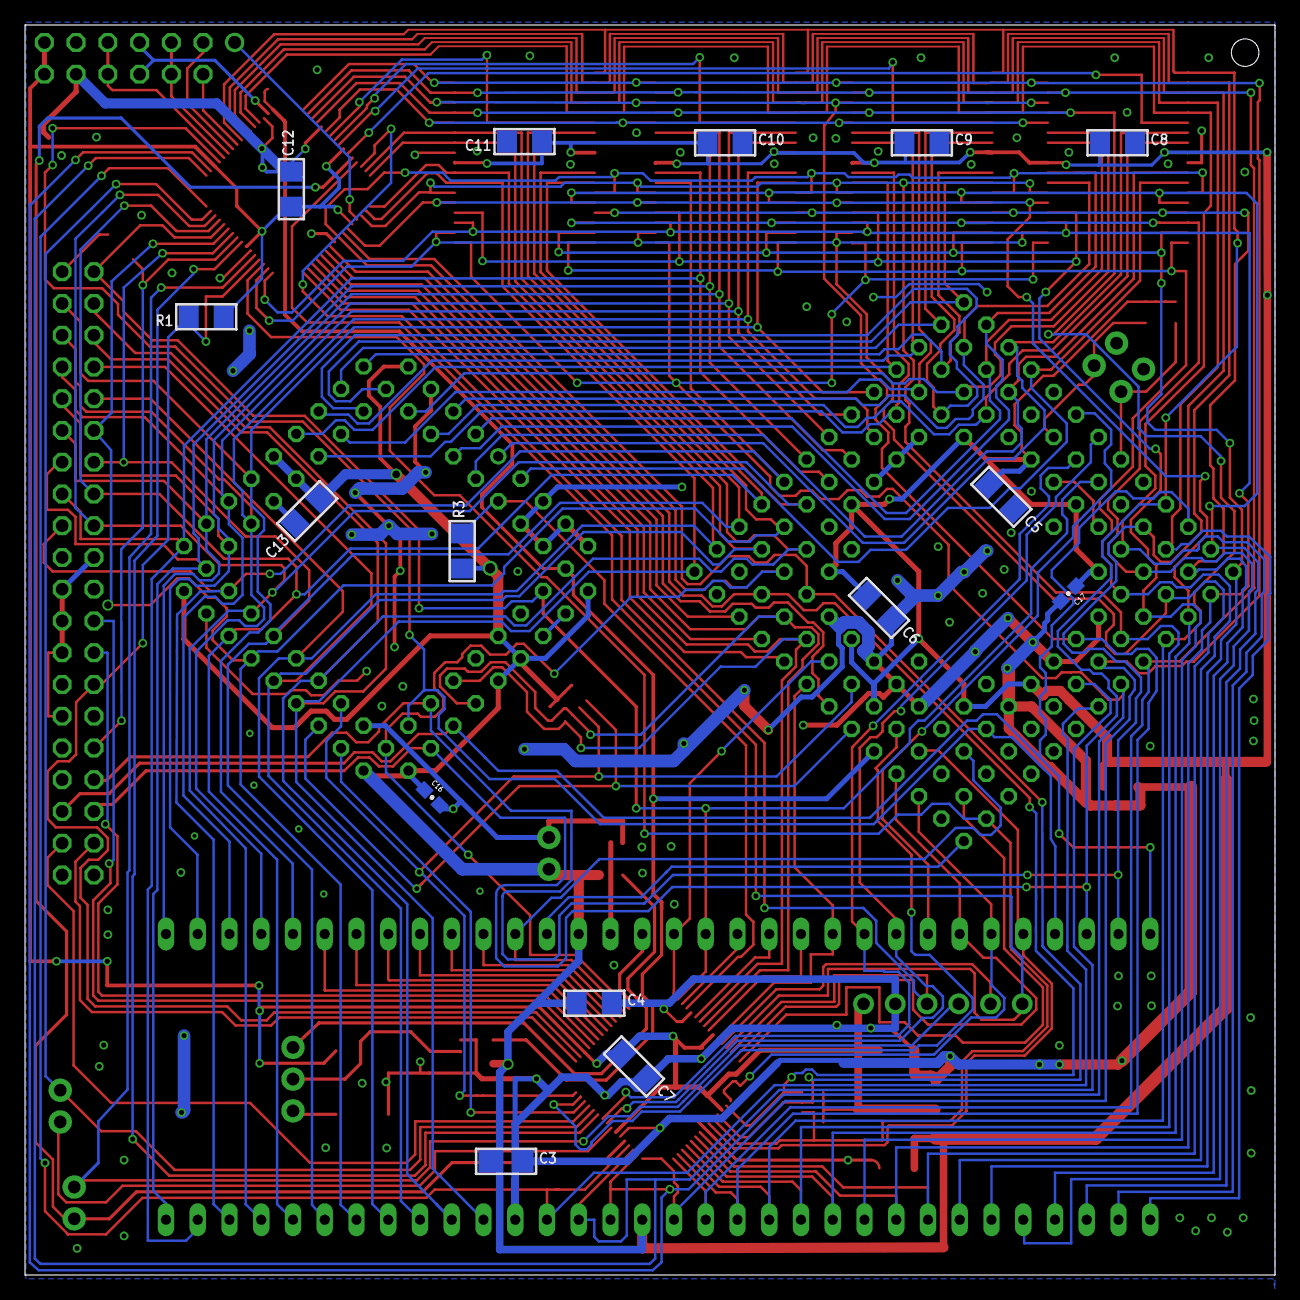
[picture p25: board SL530.brd from below]

Board: 2 copper layers, 100.0 x 100.0 mm, 46 parts (15 on the bottom side), 125 nets.
