arananet/TF-HARDWARE/tf520/eagle/tf520.brd

## EAGLE design tf520/eagle/tf520.brd (2017-04-06)

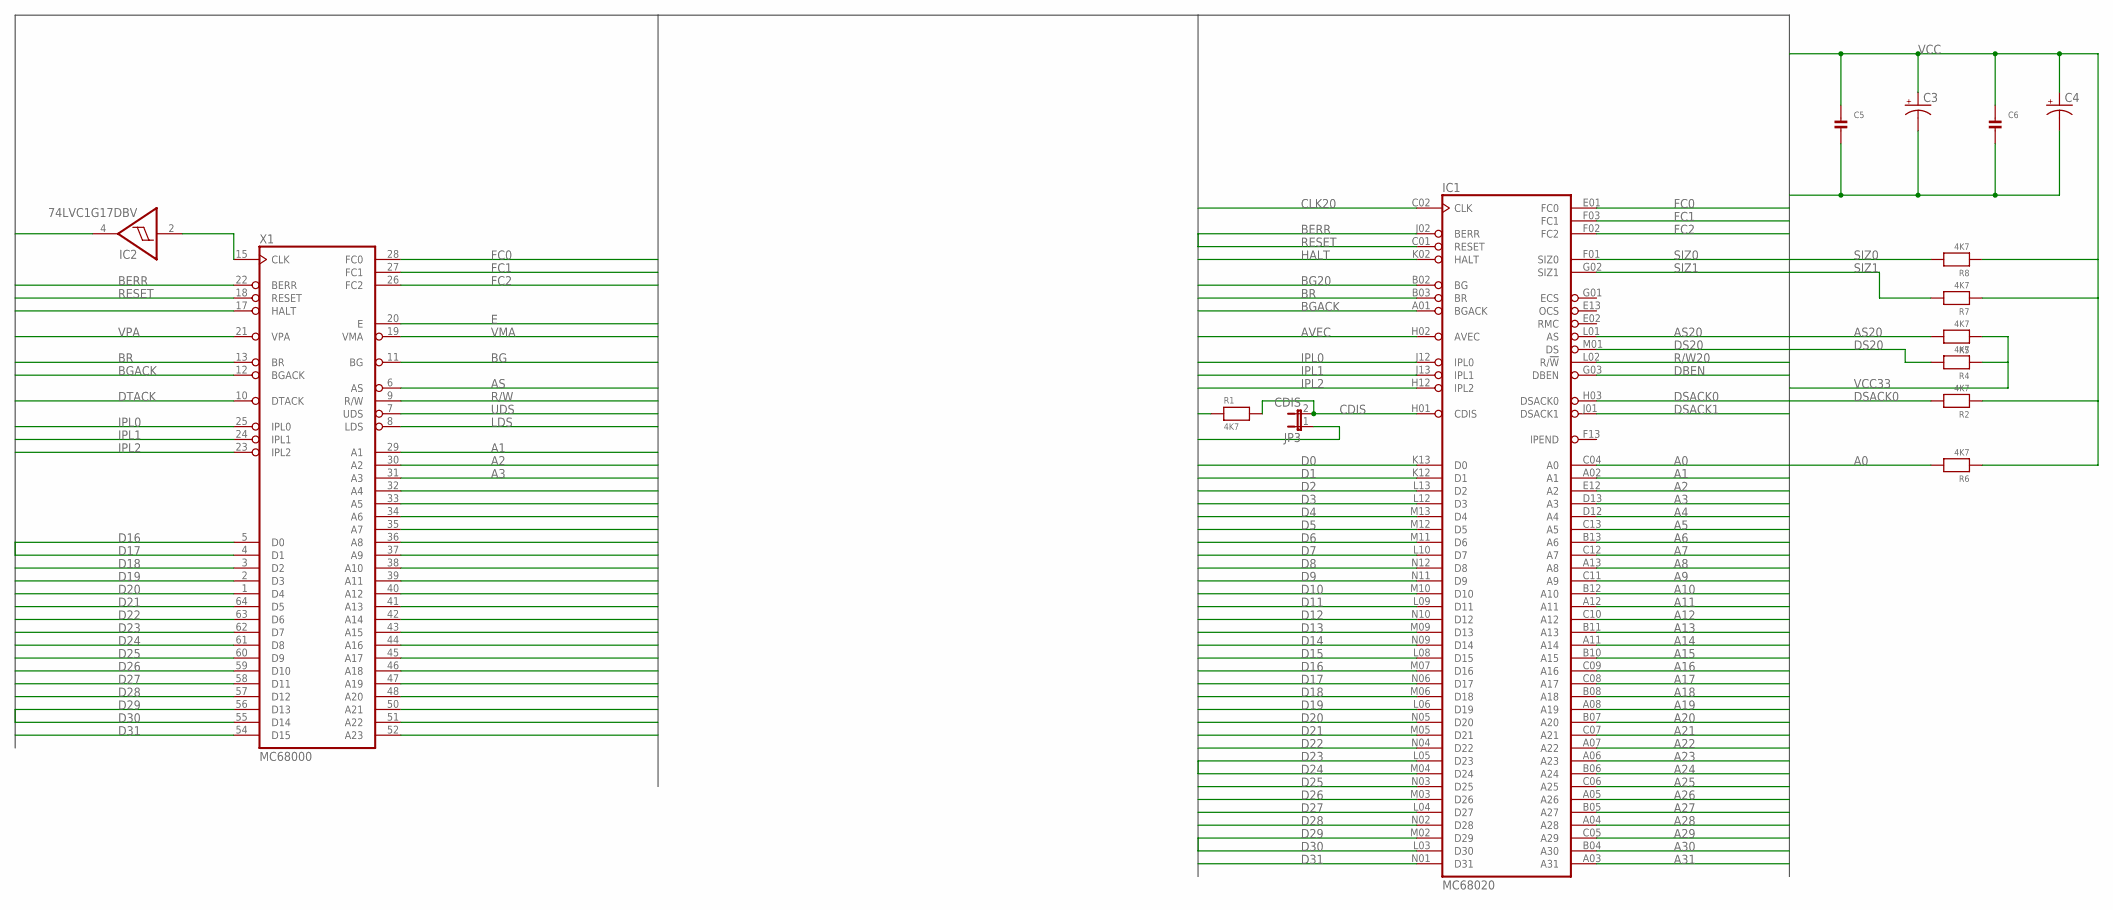
[picture p26: schematic tf520.sch, sheet 1]

Parts:
C3, C4: CAP_POLD; PANASONIC_D
C5, C6: CAP_CERAMIC1206; 1206
IC1: MC68020; MPGA114
IC2: 74LVC1G17DBV; SOT23-5
JP3: CDIS; 1X02
R1, R2, R4, R5, R6, R7, R8: 4K7; 1206
X1: MC68000; DIL64

Connections:
A0: IC1.C04 (A0), R6.2; also elsewhere on the board
A1: IC1.A02 (A1), X1.29 (A1)
A2: IC1.E12 (A2), X1.30 (A2)
A3: IC1.D13 (A3), X1.31 (A3)
A4: IC1.D12 (A4), X1.32 (A4)
A5: IC1.C13 (A5), X1.33 (A5)
A6: IC1.B13 (A6), X1.34 (A6)
A7: IC1.C12 (A7), X1.35 (A7)
A8: IC1.A13 (A8), X1.36 (A8)
A9: IC1.C11 (A9), X1.37 (A9)
A10: IC1.B12 (A10), X1.38 (A10)
A11: IC1.A12 (A11), X1.39 (A11)
A12: IC1.C10 (A12), X1.40 (A12)
A13: IC1.B11 (A13), X1.41 (A13)
A14: IC1.A11 (A14), X1.42 (A14)
A15: IC1.B10 (A15), X1.43 (A15)
A16: IC1.C09 (A16), X1.44 (A16); also elsewhere on the board
A17: IC1.C08 (A17), X1.45 (A17); also elsewhere on the board
A18: IC1.B08 (A18), X1.46 (A18); also elsewhere on the board
A19: IC1.A08 (A19), X1.47 (A19); also elsewhere on the board
A20: IC1.B07 (A20), X1.48 (A20)
A21: IC1.C07 (A21), X1.50 (A21)
A22: IC1.A07 (A22), X1.51 (A22)
A23: IC1.A06 (A23), X1.52 (A23)
A24: IC1.B06 (A24)
A25: IC1.C06 (A25)
A26: IC1.A05 (A26)
A27: IC1.B05 (A27)
A28: IC1.A04 (A28)
A29: IC1.C05 (A29)
A30: IC1.B04 (A30)
A31: IC1.A03 (A31)
AS: X1.6 (AS); also elsewhere on the board
AS20: IC1.L01 (AS), R5.2; also elsewhere on the board
AVEC: IC1.H02 (AVEC); also elsewhere on the board
BERR: IC1.J02 (BERR), X1.22 (BERR); also elsewhere on the board
BG: X1.11 (BG); also elsewhere on the board
BG20: IC1.B02 (BG); also elsewhere on the board
BGACK: IC1.A01 (BGACK), X1.12 (BGACK); also elsewhere on the board
BR: IC1.B03 (BR), X1.13 (BR)
CDIS: IC1.H01 (CDIS), JP3.2, R1.2
CLK7M: IC2.4 (O); also elsewhere on the board
CLK7M_RAW: IC2.2 (I), X1.15 (CLK)
CLK20: IC1.C02 (CLK); also elsewhere on the board
D0: IC1.K13 (D0)
D1: IC1.K12 (D1)
D2: IC1.L13 (D2)
D3: IC1.L12 (D3)
D4: IC1.M13 (D4)
D5: IC1.M12 (D5)
D6: IC1.M11 (D6)
D7: IC1.L10 (D7)
D8: IC1.N12 (D8)
D9: IC1.N11 (D9)
D10: IC1.M10 (D10)
D11: IC1.L09 (D11)
D12: IC1.N10 (D12)
D13: IC1.M09 (D13)
D14: IC1.N09 (D14)
D15: IC1.L08 (D15)
D16: IC1.M07 (D16), X1.5 (D0)
D17: IC1.N06 (D17), X1.4 (D1)
D18: IC1.M06 (D18), X1.3 (D2)
D19: IC1.L06 (D19), X1.2 (D3)
D20: IC1.N05 (D20), X1.1 (D4)
D21: IC1.M05 (D21), X1.64 (D5)
D22: IC1.N04 (D22), X1.63 (D6)
D23: IC1.L05 (D23), X1.62 (D7)
D24: IC1.M04 (D24), X1.61 (D8)
D25: IC1.N03 (D25), X1.60 (D9)
D26: IC1.M03 (D26), X1.59 (D10)
D27: IC1.L04 (D27), X1.58 (D11)
D28: IC1.N02 (D28), X1.57 (D12)
D29: IC1.M02 (D29), X1.56 (D13)
D30: IC1.L03 (D30), X1.55 (D14)
D31: IC1.N01 (D31), X1.54 (D15)
DBEN: IC1.G03 (DBEN)
DS20: IC1.M01 (DS), R4.2; also elsewhere on the board
DSACK0: IC1.H03 (DSACK0), R2.2
DSACK1: IC1.J01 (DSACK1); also elsewhere on the board
DTACK: X1.10 (DTACK); also elsewhere on the board
E: X1.20 (E); also elsewhere on the board
FC0: IC1.E01 (FC0), X1.28 (FC0); also elsewhere on the board
FC1: IC1.F03 (FC1), X1.27 (FC1); also elsewhere on the board
FC2: IC1.F02 (FC2), X1.26 (FC2); also elsewhere on the board
GND: C3.-, C4.-, C5.2, C6.2, IC1.A10 (GND), IC1.B01 (GND), IC1.B09 (GND), IC1.C03 (GND), IC1.F12 (GND), IC1.G12 (GND), IC1.H13 (GND), IC1.J03 (GND), IC1.K01 (GND), IC1.K03 (GND), IC1.L07 (GND), IC1.L11 (GND), IC1.N07 (GND), IC2.3 (GND), JP3.1, X1.16 (GND), X1.53 (GND); also elsewhere on the board
HALT: IC1.K02 (HALT), X1.17 (HALT); also elsewhere on the board
IPL0: IC1.J12 (IPL0), X1.25 (IPL0)
IPL1: IC1.J13 (IPL1), X1.24 (IPL1)
IPL2: IC1.H12 (IPL2), X1.23 (IPL2)
LDS: X1.8 (LDS); also elsewhere on the board
R/W: X1.9 (R/W); also elsewhere on the board
R/W20: IC1.L02 (R/!W); also elsewhere on the board
RESET: IC1.C01 (RESET), X1.18 (RESET); also elsewhere on the board
SIZ0: IC1.F01 (SIZ0), R8.2; also elsewhere on the board
SIZ1: IC1.G02 (SIZ1), R7.2; also elsewhere on the board
UDS: X1.7 (UDS); also elsewhere on the board
VCC: C3.+, C4.+, C5.1, C6.1, IC1.A09 (VCC), IC1.D01 (VCC), IC1.D02 (VCC), IC1.D03 (VCC), IC1.E03 (VCC), IC1.G11 (VCC), IC1.G13 (VCC), IC1.M08 (VCC), IC1.N08 (VCC), IC1.N13 (VCC), IC2.5 (VCC), R1.1, R2.1, R6.1, R7.1, R8.1, X1.14 (VCC), X1.49 (VCC); also elsewhere on the board
VCC33: R4.1, R5.1; also elsewhere on the board
VMA: X1.19 (VMA); also elsewhere on the board
VPA: X1.21 (VPA); also elsewhere on the board

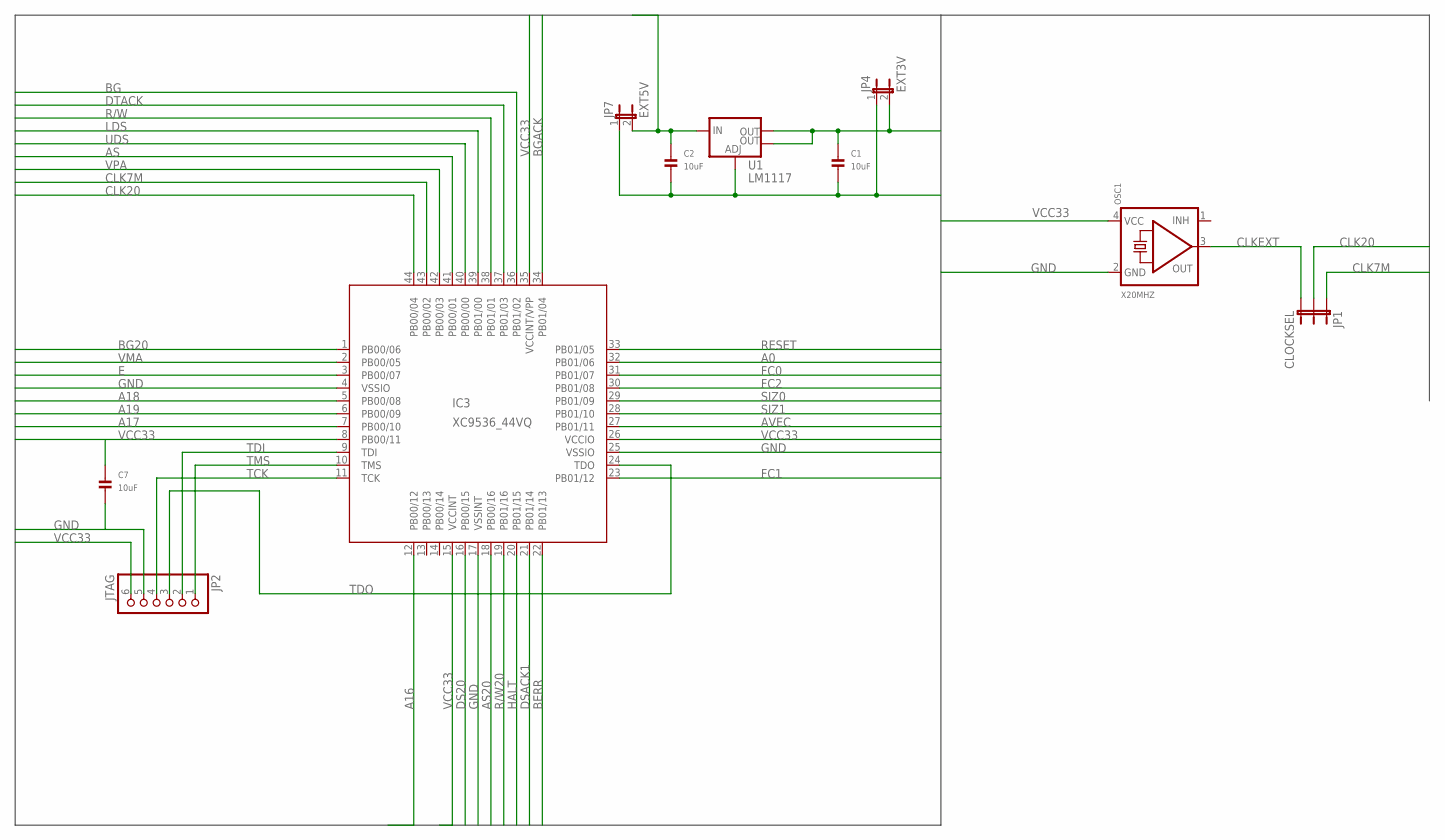
[picture p27: schematic tf520.sch, sheet 2]

Parts:
C1, C2, C7: 10uF; 1206
IC3: XC9536_44VQ; SQFP-S-10X10-44
JP1: CLOCKSEL; 1X03
JP2: JTAG; 1X06_ROUND
JP4: EXT3V; 1X02
JP7: EXT5V; JP1
OSC1: X20MHZ; OSC_7X5MM
U1: LM1117; SOT223

Connections:
A0: IC3.32 (PB01/06); also elsewhere on the board
A16: IC3.12 (PB00/12); also elsewhere on the board
A17: IC3.7 (PB00/10); also elsewhere on the board
A18: IC3.5 (PB00/08); also elsewhere on the board
A19: IC3.6 (PB00/09); also elsewhere on the board
AS: IC3.41 (PB00/01); also elsewhere on the board
AS20: IC3.18 (PB00/16); also elsewhere on the board
AVEC: IC3.27 (PB01/11); also elsewhere on the board
BERR: IC3.22 (PB01/13); also elsewhere on the board
BG: IC3.36 (PB01/02); also elsewhere on the board
BG20: IC3.1 (PB00/06); also elsewhere on the board
BGACK: IC3.34 (PB01/04); also elsewhere on the board
CLK7M: IC3.43 (PB00/02), JP1.1; also elsewhere on the board
CLK20: IC3.44 (PB00/04), JP1.2; also elsewhere on the board
CLKEXT: JP1.3, OSC1.3 (OUT)
DS20: IC3.16 (PB00/15); also elsewhere on the board
DSACK1: IC3.21 (PB01/14); also elsewhere on the board
DTACK: IC3.37 (PB01/03); also elsewhere on the board
E: IC3.3 (PB00/07); also elsewhere on the board
FC0: IC3.31 (PB01/07); also elsewhere on the board
FC1: IC3.23 (PB01/12); also elsewhere on the board
FC2: IC3.30 (PB01/08); also elsewhere on the board
GND: C1.2, C2.2, C7.2, IC3.4 (VSSIO), IC3.17 (VSSINT), IC3.25 (VSSIO), JP2.5, JP4.1, JP7.1, OSC1.2 (GND), U1.1 (ADJ); also elsewhere on the board
HALT: IC3.20 (PB01/15); also elsewhere on the board
LDS: IC3.39 (PB01/00); also elsewhere on the board
R/W: IC3.38 (PB01/01); also elsewhere on the board
R/W20: IC3.19 (PB01/16); also elsewhere on the board
RESET: IC3.33 (PB01/05); also elsewhere on the board
SIZ0: IC3.29 (PB01/09); also elsewhere on the board
SIZ1: IC3.28 (PB01/10); also elsewhere on the board
TCK: IC3.11 (TCK), JP2.4
TDI: IC3.9 (TDI), JP2.2
TDO: IC3.24 (TDO), JP2.3
TMS: IC3.10 (TMS), JP2.1
UDS: IC3.40 (PB00/00); also elsewhere on the board
VCC: C2.1, JP7.2, U1.3 (IN); also elsewhere on the board
VCC33: C1.1, C7.1, IC3.8 (PB00/11), IC3.15 (VCCINT), IC3.26 (VCCIO), IC3.35 (VCCINT/VPP), JP2.6, JP4.2, OSC1.4 (VCC), U1.2 (OUT), U1.4 (OUT); also elsewhere on the board
VMA: IC3.2 (PB00/05); also elsewhere on the board
VPA: IC3.42 (PB00/03); also elsewhere on the board

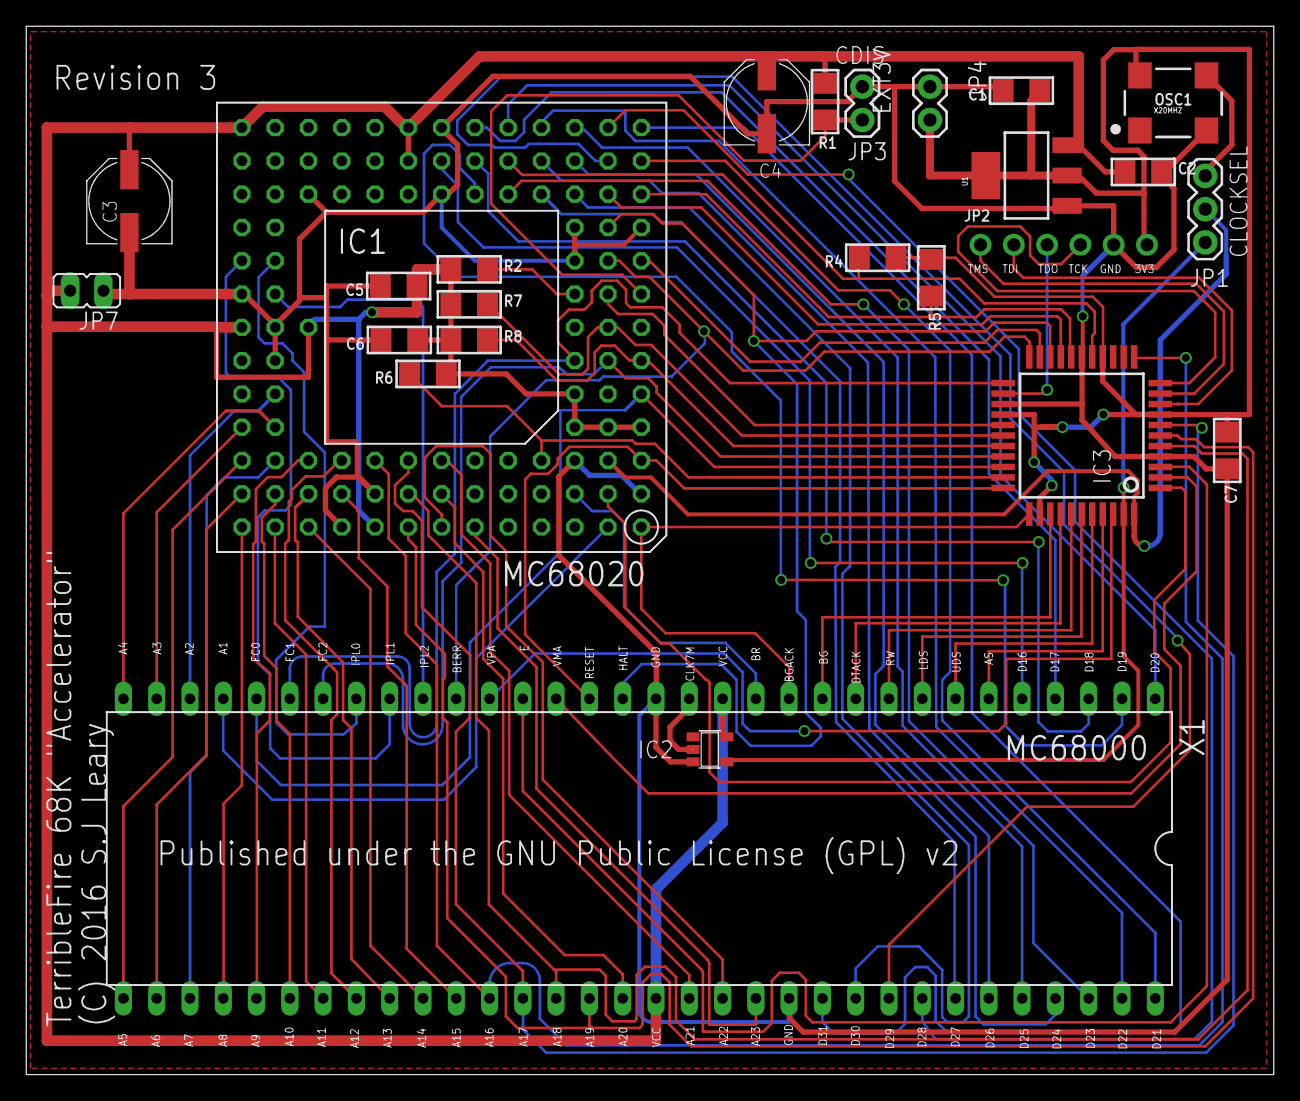
[picture p28: board tf520.brd from above]

Board: 2 copper layers, 95.2 x 80.0 mm, 25 parts (0 on the bottom side), 81 nets.
