arananet/TF-HARDWARE/breakout/cd32/eagle/cd32.brd

## EAGLE design breakout/cd32/eagle/cd32.brd (2017-04-06)

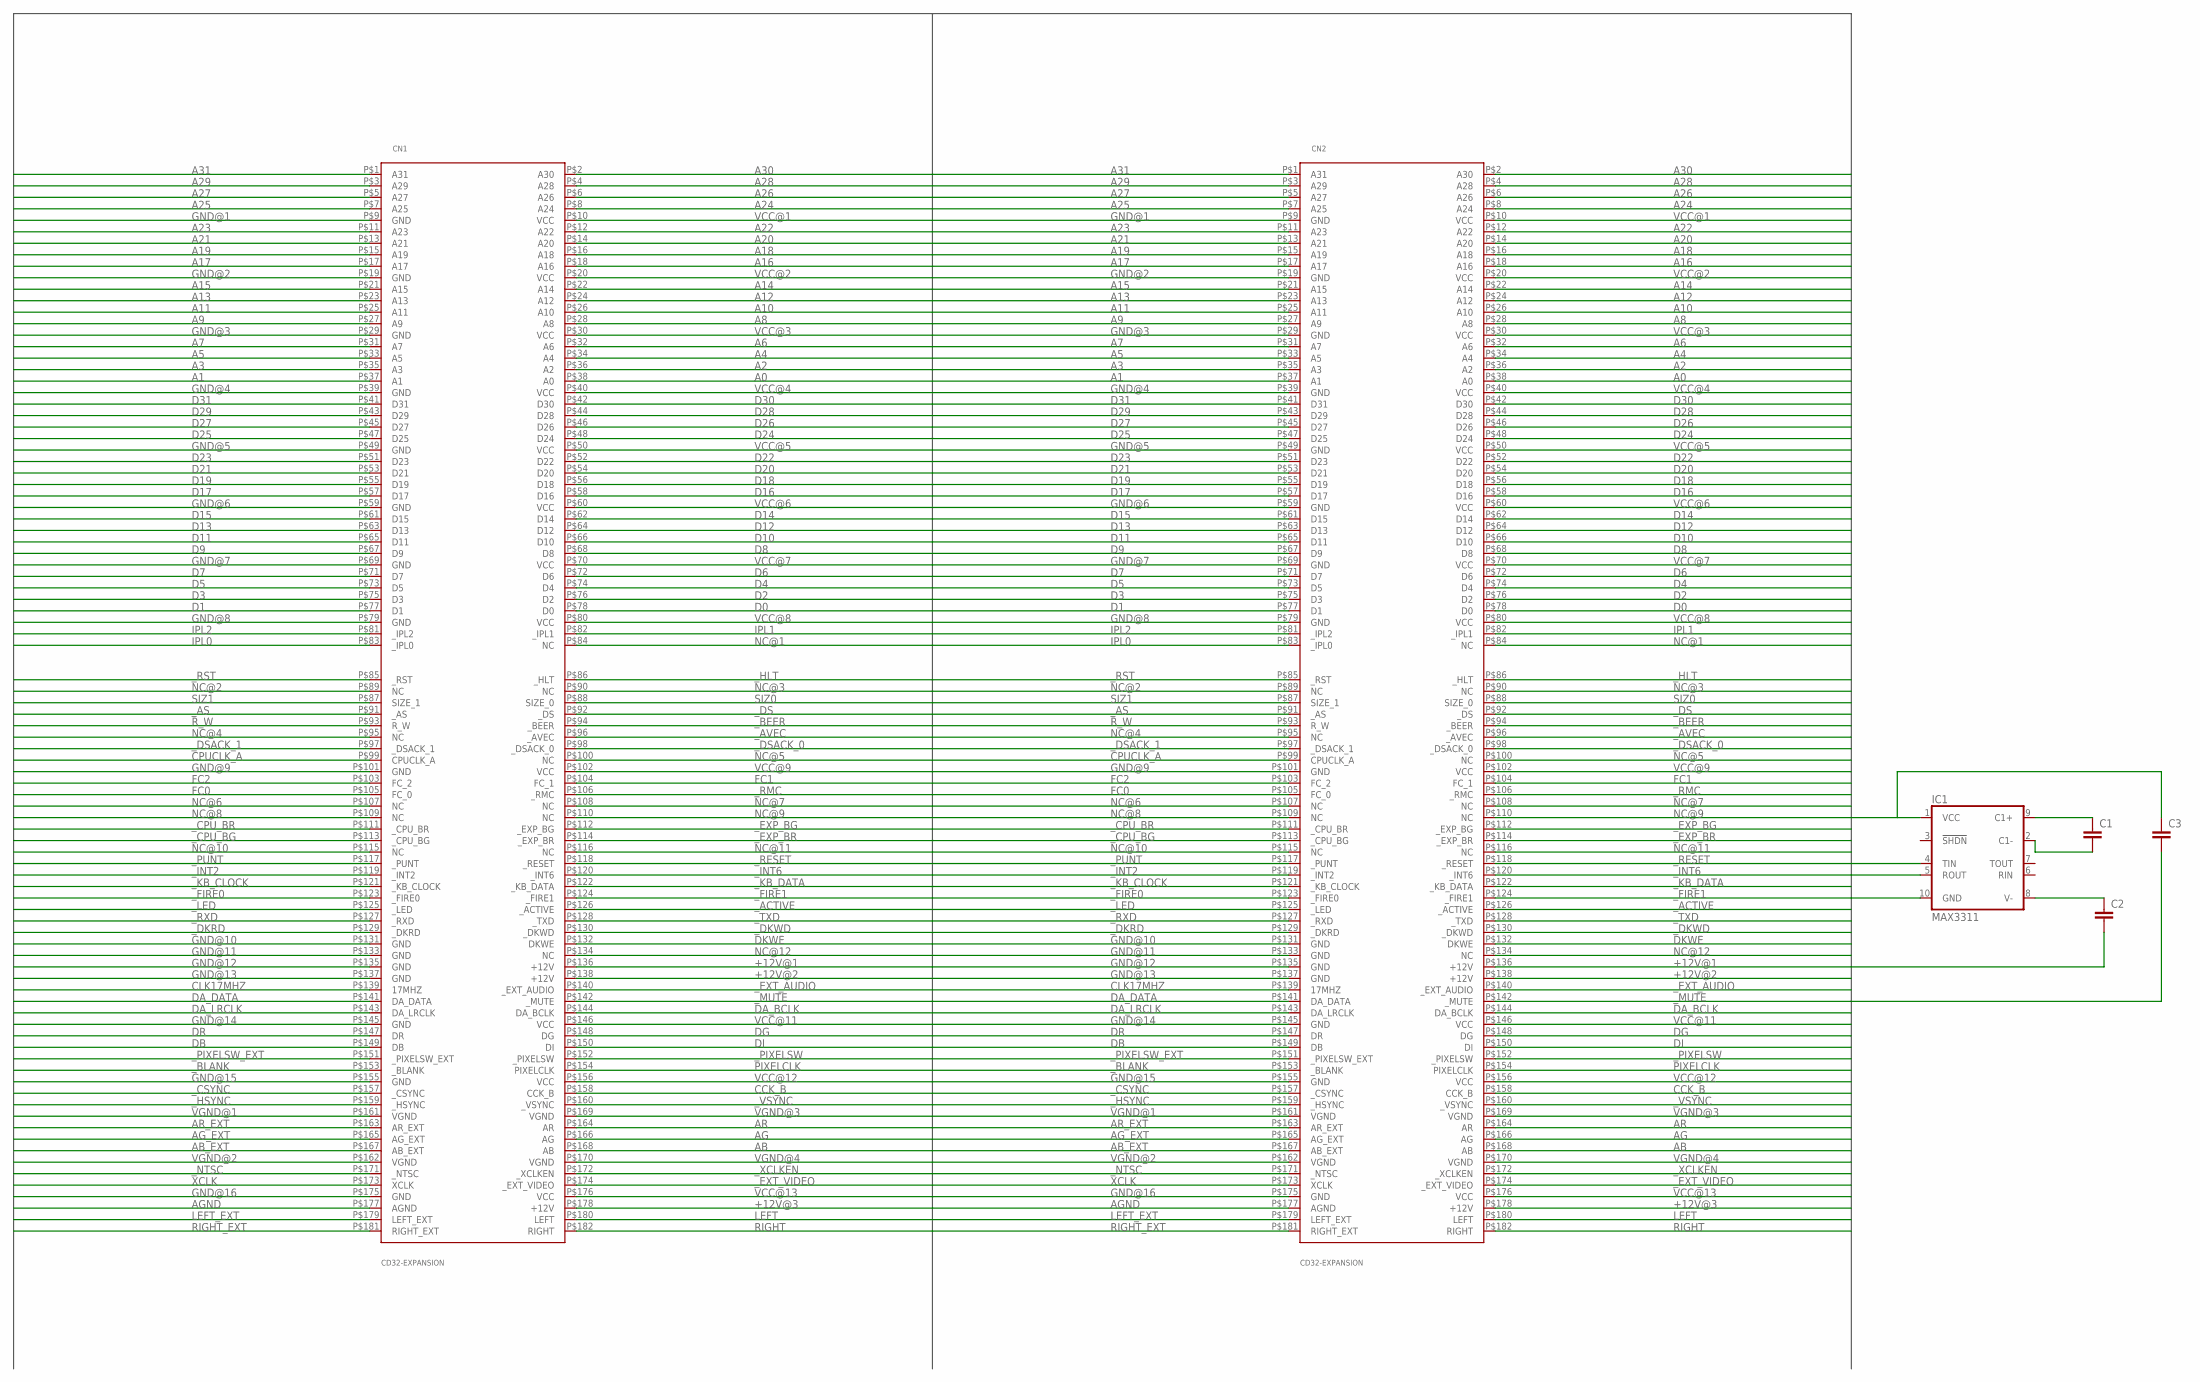
[picture p32: schematic cd32.sch]

Parts:
C1, C2, C3: CC1206; C1206
CN1, CN2: CD32-EXPANSION; CD32_EXPANSION_182_MCA
IC1: MAX3311; UMAX10

Connections:
+12V@1: C2.2, CN1.P$136 (+12V), CN2.P$136 (+12V)
+12V@2: CN1.P$138 (+12V), CN2.P$138 (+12V)
+12V@3: CN1.P$178 (+12V), CN2.P$178 (+12V)
A0: CN1.P$38 (A0), CN2.P$38 (A0)
A1: CN1.P$37 (A1), CN2.P$37 (A1)
A2: CN1.P$36 (A2), CN2.P$36 (A2)
A3: CN1.P$35 (A3), CN2.P$35 (A3)
A4: CN1.P$34 (A4), CN2.P$34 (A4)
A5: CN1.P$33 (A5), CN2.P$33 (A5)
A6: CN1.P$32 (A6), CN2.P$32 (A6)
A7: CN1.P$31 (A7), CN2.P$31 (A7)
A8: CN1.P$28 (A8), CN2.P$28 (A8)
A9: CN1.P$27 (A9), CN2.P$27 (A9)
A10: CN1.P$26 (A10), CN2.P$26 (A10)
A11: CN1.P$25 (A11), CN2.P$25 (A11)
A12: CN1.P$24 (A12), CN2.P$24 (A12)
A13: CN1.P$23 (A13), CN2.P$23 (A13)
A14: CN1.P$22 (A14), CN2.P$22 (A14)
A15: CN1.P$21 (A15), CN2.P$21 (A15)
A16: CN1.P$18 (A16), CN2.P$18 (A16)
A17: CN1.P$17 (A17), CN2.P$17 (A17)
A18: CN1.P$16 (A18), CN2.P$16 (A18)
A19: CN1.P$15 (A19), CN2.P$15 (A19)
A20: CN1.P$14 (A20), CN2.P$14 (A20)
A21: CN1.P$13 (A21), CN2.P$13 (A21)
A22: CN1.P$12 (A22), CN2.P$12 (A22)
A23: CN1.P$11 (A23), CN2.P$11 (A23)
A24: CN1.P$8 (A24), CN2.P$8 (A24)
A25: CN1.P$7 (A25), CN2.P$7 (A25)
A26: CN1.P$6 (A26), CN2.P$6 (A26)
A27: CN1.P$5 (A27), CN2.P$5 (A27)
A28: CN1.P$4 (A28), CN2.P$4 (A28)
A29: CN1.P$3 (A29), CN2.P$3 (A29)
A30: CN1.P$2 (A30), CN2.P$2 (A30)
A31: CN1.P$1 (A31), CN2.P$1 (A31)
AB: CN1.P$168 (AB), CN2.P$168 (AB)
AB_EXT: CN1.P$167 (AB_EXT), CN2.P$167 (AB_EXT)
AG: CN1.P$166 (AG), CN2.P$166 (AG)
AGND: CN1.P$177 (AGND), CN2.P$177 (AGND)
AG_EXT: CN1.P$165 (AG_EXT), CN2.P$165 (AG_EXT)
AR: CN1.P$164 (AR), CN2.P$164 (AR)
AR_EXT: CN1.P$163 (AR_EXT), CN2.P$163 (AR_EXT)
CCK_B: CN1.P$158 (CCK_B), CN2.P$158 (CCK_B)
CLK17MHZ: CN1.P$139 (17MHZ), CN2.P$139 (17MHZ)
CPUCLK_A: CN1.P$99 (CPUCLK_A), CN2.P$99 (CPUCLK_A)
D0: CN1.P$78 (D0), CN2.P$78 (D0)
D1: CN1.P$77 (D1), CN2.P$77 (D1)
D2: CN1.P$76 (D2), CN2.P$76 (D2)
D3: CN1.P$75 (D3), CN2.P$75 (D3)
D4: CN1.P$74 (D4), CN2.P$74 (D4)
D5: CN1.P$73 (D5), CN2.P$73 (D5)
D6: CN1.P$72 (D6), CN2.P$72 (D6)
D7: CN1.P$71 (D7), CN2.P$71 (D7)
D8: CN1.P$68 (D8), CN2.P$68 (D8)
D9: CN1.P$67 (D9), CN2.P$67 (D9)
D10: CN1.P$66 (D10), CN2.P$66 (D10)
D11: CN1.P$65 (D11), CN2.P$65 (D11)
D12: CN1.P$64 (D12), CN2.P$64 (D12)
D13: CN1.P$63 (D13), CN2.P$63 (D13)
D14: CN1.P$62 (D14), CN2.P$62 (D14)
D15: CN1.P$61 (D15), CN2.P$61 (D15)
D16: CN1.P$58 (D16), CN2.P$58 (D16)
D17: CN1.P$57 (D17), CN2.P$57 (D17)
D18: CN1.P$56 (D18), CN2.P$56 (D18)
D19: CN1.P$55 (D19), CN2.P$55 (D19)
D20: CN1.P$54 (D20), CN2.P$54 (D20)
D21: CN1.P$53 (D21), CN2.P$53 (D21)
D22: CN1.P$52 (D22), CN2.P$52 (D22)
D23: CN1.P$51 (D23), CN2.P$51 (D23)
D24: CN1.P$48 (D24), CN2.P$48 (D24)
D25: CN1.P$47 (D25), CN2.P$47 (D25)
D26: CN1.P$46 (D26), CN2.P$46 (D26)
D27: CN1.P$45 (D27), CN2.P$45 (D27)
D28: CN1.P$44 (D28), CN2.P$44 (D28)
D29: CN1.P$43 (D29), CN2.P$43 (D29)
D30: CN1.P$42 (D30), CN2.P$42 (D30)
D31: CN1.P$41 (D31), CN2.P$41 (D31)
DA_BCLK: CN1.P$144 (DA_BCLK), CN2.P$144 (DA_BCLK)
DA_DATA: CN1.P$141 (DA_DATA), CN2.P$141 (DA_DATA)
DA_LRCLK: CN1.P$143 (DA_LRCLK), CN2.P$143 (DA_LRCLK)
DB: CN1.P$149 (DB), CN2.P$149 (DB)
DG: CN1.P$148 (DG), CN2.P$148 (DG)
DI: CN1.P$150 (DI), CN2.P$150 (DI)
DKWE: CN1.P$132 (DKWE), CN2.P$132 (DKWE)
DR: CN1.P$147 (DR), CN2.P$147 (DR)
FC0: CN1.P$105 (FC_0), CN2.P$105 (FC_0)
FC1: CN1.P$104 (FC_1), CN2.P$104 (FC_1)
FC2: CN1.P$103 (FC_2), CN2.P$103 (FC_2)
GND: C3.2, IC1.10 (GND)
GND@1: CN1.P$9 (GND), CN2.P$9 (GND)
GND@2: CN1.P$19 (GND), CN2.P$19 (GND)
GND@3: CN1.P$29 (GND), CN2.P$29 (GND)
GND@4: CN1.P$39 (GND), CN2.P$39 (GND)
GND@5: CN1.P$49 (GND), CN2.P$49 (GND)
GND@6: CN1.P$59 (GND), CN2.P$59 (GND)
GND@7: CN1.P$69 (GND), CN2.P$69 (GND)
GND@8: CN1.P$79 (GND), CN2.P$79 (GND)
GND@9: CN1.P$101 (GND), CN2.P$101 (GND)
GND@10: CN1.P$131 (GND), CN2.P$131 (GND)
GND@11: CN1.P$133 (GND), CN2.P$133 (GND)
GND@12: CN1.P$135 (GND), CN2.P$135 (GND)
GND@13: CN1.P$137 (GND), CN2.P$137 (GND)
GND@14: CN1.P$145 (GND), CN2.P$145 (GND)
GND@15: CN1.P$155 (GND), CN2.P$155 (GND)
GND@16: CN1.P$175 (GND), CN2.P$175 (GND)
IPL0: CN1.P$83 (_IPL0), CN2.P$83 (_IPL0)
IPL1: CN1.P$82 (_IPL1), CN2.P$82 (_IPL1)
IPL2: CN1.P$81 (_IPL2), CN2.P$81 (_IPL2)
LEFT: CN1.P$180 (LEFT), CN2.P$180 (LEFT)
LEFT_EXT: CN1.P$179 (LEFT_EXT), CN2.P$179 (LEFT_EXT)
unnamed: C1.1, IC1.9 (C1+)
unnamed: C1.2, IC1.2 (C1-)
unnamed: C2.1, IC1.8 (V-)
NC@1: CN1.P$84 (NC), CN2.P$84 (NC)
NC@2: CN1.P$89 (NC), CN2.P$89 (NC)
NC@3: CN1.P$90 (NC), CN2.P$90 (NC)
NC@4: CN1.P$95 (NC), CN2.P$95 (NC)
NC@5: CN1.P$100 (NC), CN2.P$100 (NC)
NC@6: CN1.P$107 (NC), CN2.P$107 (NC)
NC@7: CN1.P$108 (NC), CN2.P$108 (NC)
NC@8: CN1.P$109 (NC), CN2.P$109 (NC)
NC@9: CN1.P$110 (NC), CN2.P$110 (NC)
NC@10: CN1.P$115 (NC), CN2.P$115 (NC)
NC@11: CN1.P$116 (NC), CN2.P$116 (NC)
NC@12: CN1.P$134 (NC), CN2.P$134 (NC)
PIXELCLK: CN1.P$154 (PIXELCLK), CN2.P$154 (PIXELCLK)
RIGHT: CN1.P$182 (RIGHT), CN2.P$182 (RIGHT)
RIGHT_EXT: CN1.P$181 (RIGHT_EXT), CN2.P$181 (RIGHT_EXT)
R_W: CN1.P$93 (R_W), CN2.P$93 (R_W)
SIZ0: CN1.P$88 (SIZE_0), CN2.P$88 (SIZE_0)
SIZ1: CN1.P$87 (SIZE_1), CN2.P$87 (SIZE_1)
VCC: C3.1, IC1.1 (VCC)
VCC@1: CN1.P$10 (VCC), CN2.P$10 (VCC)
VCC@2: CN1.P$20 (VCC), CN2.P$20 (VCC)
VCC@3: CN1.P$30 (VCC), CN2.P$30 (VCC)
VCC@4: CN1.P$40 (VCC), CN2.P$40 (VCC)
VCC@5: CN1.P$50 (VCC), CN2.P$50 (VCC)
VCC@6: CN1.P$60 (VCC), CN2.P$60 (VCC)
VCC@7: CN1.P$70 (VCC), CN2.P$70 (VCC)
VCC@8: CN1.P$80 (VCC), CN2.P$80 (VCC)
VCC@9: CN1.P$102 (VCC), CN2.P$102 (VCC)
VCC@11: CN1.P$146 (VCC), CN2.P$146 (VCC)
VCC@12: CN1.P$156 (VCC), CN2.P$156 (VCC)
VCC@13: CN1.P$176 (VCC), CN2.P$176 (VCC)
VGND@1: CN1.P$161 (VGND), CN2.P$161 (VGND)
VGND@2: CN1.P$162 (VGND), CN2.P$162 (VGND)
VGND@3: CN1.P$169 (VGND), CN2.P$169 (VGND)
VGND@4: CN1.P$170 (VGND), CN2.P$170 (VGND)
XCLK: CN1.P$173 (XCLK), CN2.P$173 (XCLK)
_ACTIVE: CN1.P$126 (_ACTIVE), CN2.P$126 (_ACTIVE)
_AS: CN1.P$91 (_AS), CN2.P$91 (_AS)
_AVEC: CN1.P$96 (_AVEC), CN2.P$96 (_AVEC)
_BEER: CN1.P$94 (_BEER), CN2.P$94 (_BEER)
_BLANK: CN1.P$153 (_BLANK), CN2.P$153 (_BLANK)
_CPU_BG: CN1.P$113 (_CPU_BG), CN2.P$113 (_CPU_BG)
_CPU_BR: CN1.P$111 (_CPU_BR), CN2.P$111 (_CPU_BR)
_CSYNC: CN1.P$157 (_CSYNC), CN2.P$157 (_CSYNC)
_DKRD: CN1.P$129 (_DKRD), CN2.P$129 (_DKRD)
_DKWD: CN1.P$130 (_DKWD), CN2.P$130 (_DKWD)
_DS: CN1.P$92 (_DS), CN2.P$92 (_DS)
_DSACK_0: CN1.P$98 (_DSACK_0), CN2.P$98 (_DSACK_0)
_DSACK_1: CN1.P$97 (_DSACK_1), CN2.P$97 (_DSACK_1)
_EXP_BG: CN1.P$112 (_EXP_BG), CN2.P$112 (_EXP_BG)
_EXP_BR: CN1.P$114 (_EXP_BR), CN2.P$114 (_EXP_BR)
_EXT_AUDIO: CN1.P$140 (_EXT_AUDIO), CN2.P$140 (_EXT_AUDIO)
_EXT_VIDEO: CN1.P$174 (_EXT_VIDEO), CN2.P$174 (_EXT_VIDEO)
_FIRE0: CN1.P$123 (_FIRE0), CN2.P$123 (_FIRE0)
_FIRE1: CN1.P$124 (_FIRE1), CN2.P$124 (_FIRE1)
_HLT: CN1.P$86 (_HLT), CN2.P$86 (_HLT)
_HSYNC: CN1.P$159 (_HSYNC), CN2.P$159 (_HSYNC)
_INT2: CN1.P$119 (_INT2), CN2.P$119 (_INT2)
_INT6: CN1.P$120 (_INT6), CN2.P$120 (_INT6)
_KB_CLOCK: CN1.P$121 (_KB_CLOCK), CN2.P$121 (_KB_CLOCK)
_KB_DATA: CN1.P$122 (_KB_DATA), CN2.P$122 (_KB_DATA)
_LED: CN1.P$125 (_LED), CN2.P$125 (_LED)
_MUTE: CN1.P$142 (_MUTE), CN2.P$142 (_MUTE)
_NTSC: CN1.P$171 (_NTSC), CN2.P$171 (_NTSC)
_PIXELSW: CN1.P$152 (_PIXELSW), CN2.P$152 (_PIXELSW)
_PIXELSW_EXT: CN1.P$151 (_PIXELSW_EXT), CN2.P$151 (_PIXELSW_EXT)
_PUNT: CN1.P$117 (_PUNT), CN2.P$117 (_PUNT)
_RESET: CN1.P$118 (_RESET), CN2.P$118 (_RESET)
_RMC: CN1.P$106 (_RMC), CN2.P$106 (_RMC)
_RST: CN1.P$85 (_RST), CN2.P$85 (_RST)
_RXD: CN1.P$127 (_RXD), CN2.P$127 (_RXD), IC1.5 (ROUT)
_TXD: CN1.P$128 (_TXD), CN2.P$128 (_TXD), IC1.4 (TIN)
_VSYNC: CN1.P$160 (_VSYNC), CN2.P$160 (_VSYNC)
_XCLKEN: CN1.P$172 (_XCLKEN), CN2.P$172 (_XCLKEN)

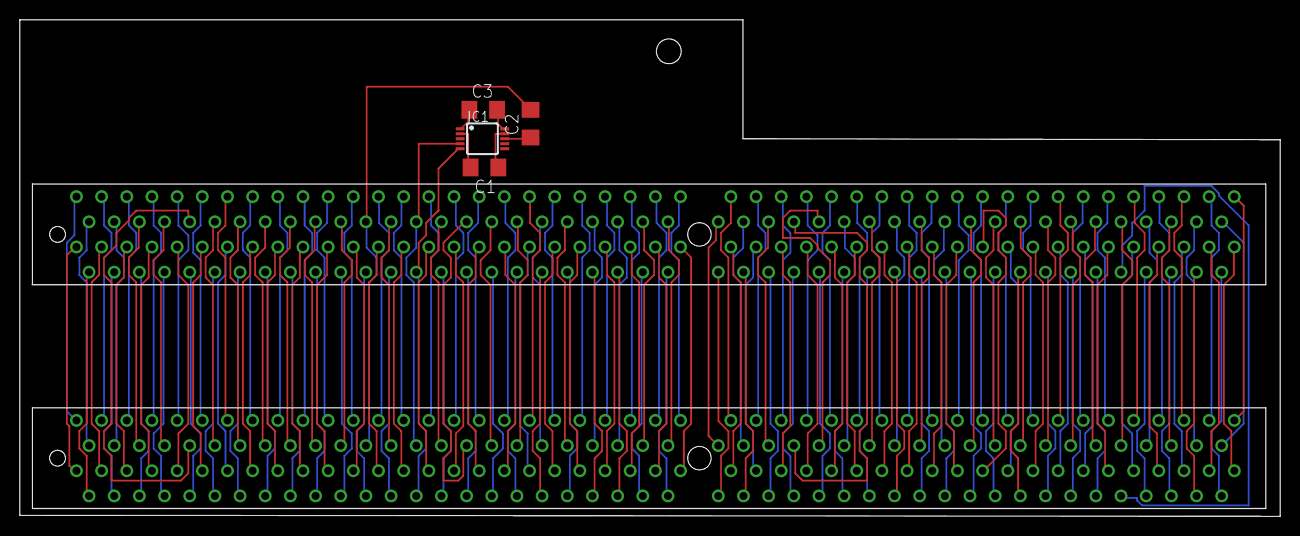
[picture p33: board cd32.brd from above]

Board: 2 copper layers, 127.2 x 50.1 mm, 6 parts (0 on the bottom side), 187 nets.
