arananet/TF-HARDWARE/breakout/68030/eagle/breakout.brd

## EAGLE design breakout/68030/eagle/breakout.brd (2017-04-06)

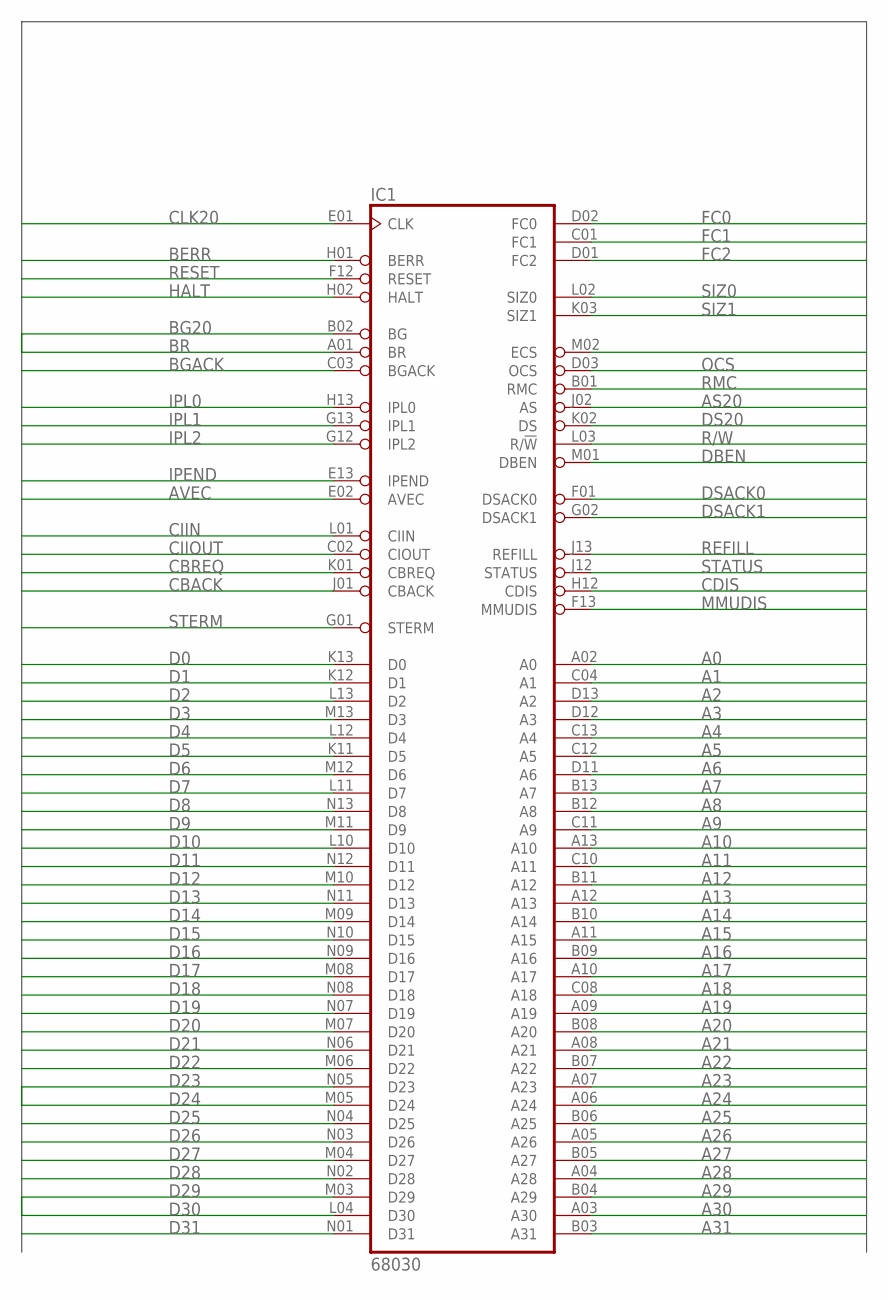
[picture p34: schematic breakout.sch, sheet 1]

Parts:
IC1: 68030; MPGA128

Connections:
A0: IC1.A02 (A0); also elsewhere on the board
A1: IC1.C04 (A1); also elsewhere on the board
A2: IC1.D13 (A2); also elsewhere on the board
A3: IC1.D12 (A3); also elsewhere on the board
A4: IC1.C13 (A4); also elsewhere on the board
A5: IC1.C12 (A5); also elsewhere on the board
A6: IC1.D11 (A6); also elsewhere on the board
A7: IC1.B13 (A7); also elsewhere on the board
A8: IC1.B12 (A8); also elsewhere on the board
A9: IC1.C11 (A9); also elsewhere on the board
A10: IC1.A13 (A10); also elsewhere on the board
A11: IC1.C10 (A11); also elsewhere on the board
A12: IC1.B11 (A12); also elsewhere on the board
A13: IC1.A12 (A13); also elsewhere on the board
A14: IC1.B10 (A14); also elsewhere on the board
A15: IC1.A11 (A15); also elsewhere on the board
A16: IC1.B09 (A16); also elsewhere on the board
A17: IC1.A10 (A17); also elsewhere on the board
A18: IC1.C08 (A18); also elsewhere on the board
A19: IC1.A09 (A19); also elsewhere on the board
A20: IC1.B08 (A20); also elsewhere on the board
A21: IC1.A08 (A21); also elsewhere on the board
A22: IC1.B07 (A22); also elsewhere on the board
A23: IC1.A07 (A23); also elsewhere on the board
A24: IC1.A06 (A24); also elsewhere on the board
A25: IC1.B06 (A25); also elsewhere on the board
A26: IC1.A05 (A26); also elsewhere on the board
A27: IC1.B05 (A27); also elsewhere on the board
A28: IC1.A04 (A28); also elsewhere on the board
A29: IC1.B04 (A29); also elsewhere on the board
A30: IC1.A03 (A30); also elsewhere on the board
A31: IC1.B03 (A31); also elsewhere on the board
AS20: IC1.J02 (AS); also elsewhere on the board
AVEC: IC1.E02 (AVEC); also elsewhere on the board
BERR: IC1.H01 (BERR); also elsewhere on the board
BG20: IC1.B02 (BG); also elsewhere on the board
BGACK: IC1.C03 (BGACK); also elsewhere on the board
BR: IC1.A01 (BR); also elsewhere on the board
CBACK: IC1.J01 (CBACK); also elsewhere on the board
CBREQ: IC1.K01 (CBREQ); also elsewhere on the board
CDIS: IC1.H12 (CDIS); also elsewhere on the board
CIIN: IC1.L01 (CIIN); also elsewhere on the board
CIIOUT: IC1.C02 (CIOUT); also elsewhere on the board
CLK20: IC1.E01 (CLK); also elsewhere on the board
D0: IC1.K13 (D0); also elsewhere on the board
D1: IC1.K12 (D1); also elsewhere on the board
D2: IC1.L13 (D2); also elsewhere on the board
D3: IC1.M13 (D3); also elsewhere on the board
D4: IC1.L12 (D4); also elsewhere on the board
D5: IC1.K11 (D5); also elsewhere on the board
D6: IC1.M12 (D6); also elsewhere on the board
D7: IC1.L11 (D7); also elsewhere on the board
D8: IC1.N13 (D8); also elsewhere on the board
D9: IC1.M11 (D9); also elsewhere on the board
D10: IC1.L10 (D10); also elsewhere on the board
D11: IC1.N12 (D11); also elsewhere on the board
D12: IC1.M10 (D12); also elsewhere on the board
D13: IC1.N11 (D13); also elsewhere on the board
D14: IC1.M09 (D14); also elsewhere on the board
D15: IC1.N10 (D15); also elsewhere on the board
D16: IC1.N09 (D16); also elsewhere on the board
D17: IC1.M08 (D17); also elsewhere on the board
D18: IC1.N08 (D18); also elsewhere on the board
D19: IC1.N07 (D19); also elsewhere on the board
D20: IC1.M07 (D20); also elsewhere on the board
D21: IC1.N06 (D21); also elsewhere on the board
D22: IC1.M06 (D22); also elsewhere on the board
D23: IC1.N05 (D23); also elsewhere on the board
D24: IC1.M05 (D24); also elsewhere on the board
D25: IC1.N04 (D25); also elsewhere on the board
D26: IC1.N03 (D26); also elsewhere on the board
D27: IC1.M04 (D27); also elsewhere on the board
D28: IC1.N02 (D28); also elsewhere on the board
D29: IC1.M03 (D29); also elsewhere on the board
D30: IC1.L04 (D30); also elsewhere on the board
D31: IC1.N01 (D31); also elsewhere on the board
DBEN: IC1.M01 (DBEN); also elsewhere on the board
DS20: IC1.K02 (DS); also elsewhere on the board
DSACK0: IC1.F01 (DSACK0); also elsewhere on the board
DSACK1: IC1.G02 (DSACK1); also elsewhere on the board
ECS: IC1.M02 (ECS); also elsewhere on the board
FC0: IC1.D02 (FC0); also elsewhere on the board
FC1: IC1.C01 (FC1); also elsewhere on the board
FC2: IC1.D01 (FC2); also elsewhere on the board
GND: IC1.C05 (GND), IC1.C07 (GND), IC1.C09 (GND), IC1.E03 (GND), IC1.E11 (GND), IC1.F03 (GND), IC1.G03 (GND), IC1.G11 (GND), IC1.J03 (GND), IC1.J11 (GND), IC1.L05 (GND), IC1.L07 (GND), IC1.L08 (GND), IC1.L09 (GND); also elsewhere on the board
HALT: IC1.H02 (HALT); also elsewhere on the board
IPEND: IC1.E13 (IPEND); also elsewhere on the board
IPL0: IC1.H13 (IPL0); also elsewhere on the board
IPL1: IC1.G13 (IPL1); also elsewhere on the board
IPL2: IC1.G12 (IPL2); also elsewhere on the board
MMUDIS: IC1.F13 (MMUDIS); also elsewhere on the board
OCS: IC1.D03 (OCS); also elsewhere on the board
R/W: IC1.L03 (R/!W); also elsewhere on the board
REFILL: IC1.J13 (REFILL); also elsewhere on the board
RESET: IC1.F12 (RESET); also elsewhere on the board
RMC: IC1.B01 (RMC); also elsewhere on the board
SIZ0: IC1.L02 (SIZ0); also elsewhere on the board
SIZ1: IC1.K03 (SIZ1); also elsewhere on the board
STATUS: IC1.J12 (STATUS); also elsewhere on the board
STERM: IC1.G01 (STERM); also elsewhere on the board
VCC: IC1.C06 (VCC), IC1.D04 (VCC), IC1.D10 (VCC), IC1.F02 (VCC), IC1.F11 (VCC), IC1.H03 (VCC), IC1.H11 (VCC), IC1.K04 (VCC), IC1.K10 (VCC), IC1.L06 (VCC); also elsewhere on the board

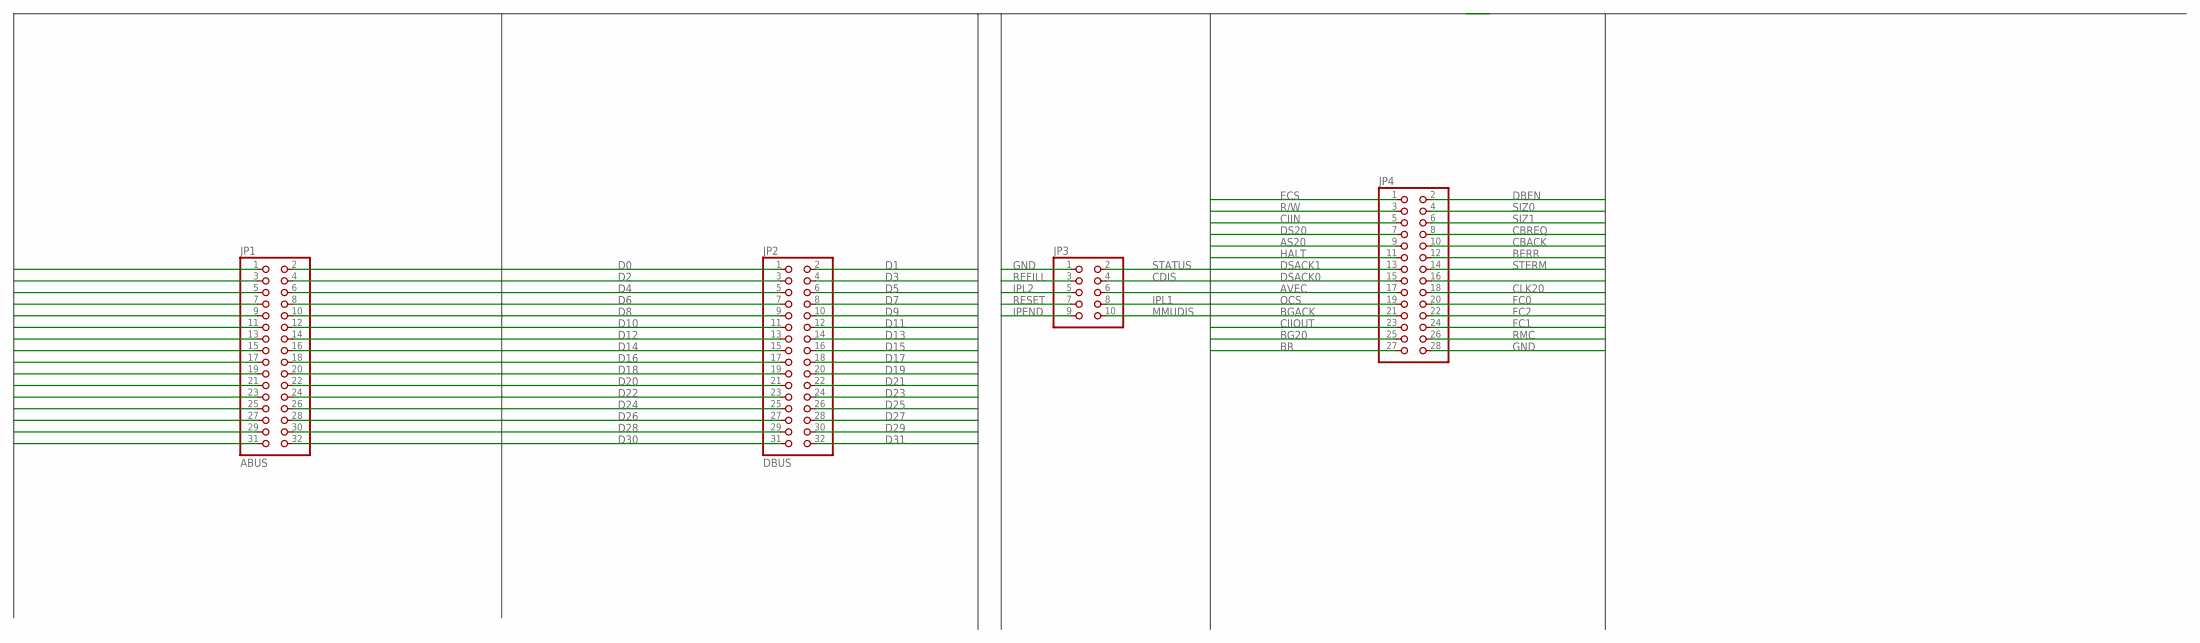
[picture p35: schematic breakout.sch, sheet 2]

Parts:
JP1: ABUS; 2X16
JP2: DBUS; 2X16
JP3: PINHD-2X5; 2X05
JP4: PINHD-2X14; 2X14

Connections:
A0: JP1.1; also elsewhere on the board
A1: JP1.2; also elsewhere on the board
A2: JP1.3; also elsewhere on the board
A3: JP1.4; also elsewhere on the board
A4: JP1.5; also elsewhere on the board
A5: JP1.6; also elsewhere on the board
A6: JP1.7; also elsewhere on the board
A7: JP1.8; also elsewhere on the board
A8: JP1.9; also elsewhere on the board
A9: JP1.10; also elsewhere on the board
A10: JP1.11; also elsewhere on the board
A11: JP1.12; also elsewhere on the board
A12: JP1.13; also elsewhere on the board
A13: JP1.14; also elsewhere on the board
A14: JP1.15; also elsewhere on the board
A15: JP1.16; also elsewhere on the board
A16: JP1.17; also elsewhere on the board
A17: JP1.18; also elsewhere on the board
A18: JP1.19; also elsewhere on the board
A19: JP1.20; also elsewhere on the board
A20: JP1.21; also elsewhere on the board
A21: JP1.22; also elsewhere on the board
A22: JP1.23; also elsewhere on the board
A23: JP1.24; also elsewhere on the board
A24: JP1.25; also elsewhere on the board
A25: JP1.26; also elsewhere on the board
A26: JP1.27; also elsewhere on the board
A27: JP1.28; also elsewhere on the board
A28: JP1.29; also elsewhere on the board
A29: JP1.30; also elsewhere on the board
A30: JP1.31; also elsewhere on the board
A31: JP1.32; also elsewhere on the board
AS20: JP4.9; also elsewhere on the board
AVEC: JP4.17; also elsewhere on the board
BERR: JP4.12; also elsewhere on the board
BG20: JP4.25; also elsewhere on the board
BGACK: JP4.21; also elsewhere on the board
BR: JP4.27; also elsewhere on the board
CBACK: JP4.10; also elsewhere on the board
CBREQ: JP4.8; also elsewhere on the board
CDIS: JP3.4; also elsewhere on the board
CIIN: JP4.5; also elsewhere on the board
CIIOUT: JP4.23; also elsewhere on the board
CLK20: JP4.18; also elsewhere on the board
D0: JP2.1; also elsewhere on the board
D1: JP2.2; also elsewhere on the board
D2: JP2.3; also elsewhere on the board
D3: JP2.4; also elsewhere on the board
D4: JP2.5; also elsewhere on the board
D5: JP2.6; also elsewhere on the board
D6: JP2.7; also elsewhere on the board
D7: JP2.8; also elsewhere on the board
D8: JP2.9; also elsewhere on the board
D9: JP2.10; also elsewhere on the board
D10: JP2.11; also elsewhere on the board
D11: JP2.12; also elsewhere on the board
D12: JP2.13; also elsewhere on the board
D13: JP2.14; also elsewhere on the board
D14: JP2.15; also elsewhere on the board
D15: JP2.16; also elsewhere on the board
D16: JP2.17; also elsewhere on the board
D17: JP2.18; also elsewhere on the board
D18: JP2.19; also elsewhere on the board
D19: JP2.20; also elsewhere on the board
D20: JP2.21; also elsewhere on the board
D21: JP2.22; also elsewhere on the board
D22: JP2.23; also elsewhere on the board
D23: JP2.24; also elsewhere on the board
D24: JP2.25; also elsewhere on the board
D25: JP2.26; also elsewhere on the board
D26: JP2.27; also elsewhere on the board
D27: JP2.28; also elsewhere on the board
D28: JP2.29; also elsewhere on the board
D29: JP2.30; also elsewhere on the board
D30: JP2.31; also elsewhere on the board
D31: JP2.32; also elsewhere on the board
DBEN: JP4.2; also elsewhere on the board
DS20: JP4.7; also elsewhere on the board
DSACK0: JP4.15; also elsewhere on the board
DSACK1: JP4.13; also elsewhere on the board
ECS: JP4.1; also elsewhere on the board
FC0: JP4.20; also elsewhere on the board
FC1: JP4.24; also elsewhere on the board
FC2: JP4.22; also elsewhere on the board
GND: JP3.1, JP4.28; also elsewhere on the board
HALT: JP4.11; also elsewhere on the board
IPEND: JP3.9; also elsewhere on the board
IPL0: JP3.6; also elsewhere on the board
IPL1: JP3.8; also elsewhere on the board
IPL2: JP3.5; also elsewhere on the board
MMUDIS: JP3.10; also elsewhere on the board
OCS: JP4.19; also elsewhere on the board
R/W: JP4.3; also elsewhere on the board
REFILL: JP3.3; also elsewhere on the board
RESET: JP3.7; also elsewhere on the board
RMC: JP4.26; also elsewhere on the board
SIZ0: JP4.4; also elsewhere on the board
SIZ1: JP4.6; also elsewhere on the board
STATUS: JP3.2; also elsewhere on the board
STERM: JP4.14; also elsewhere on the board
VCC: JP4.16; also elsewhere on the board

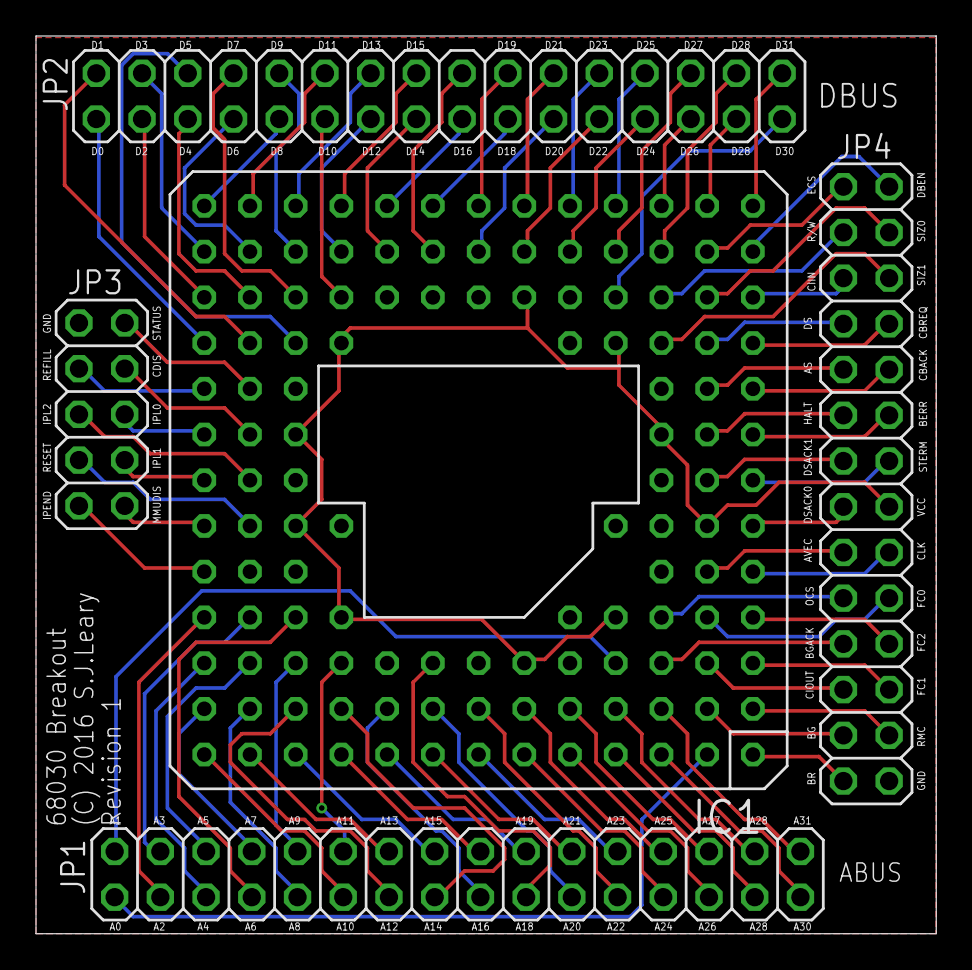
[picture p36: board breakout/68030/eagle/breakout.brd from above]

Board: 2 copper layers, 50.0 x 49.9 mm, 5 parts (0 on the bottom side), 101 nets.
