arananet/TF-HARDWARE/a3640/eagle/a3640.brd

## EAGLE design a3640/eagle/a3640.brd (2017-04-06)

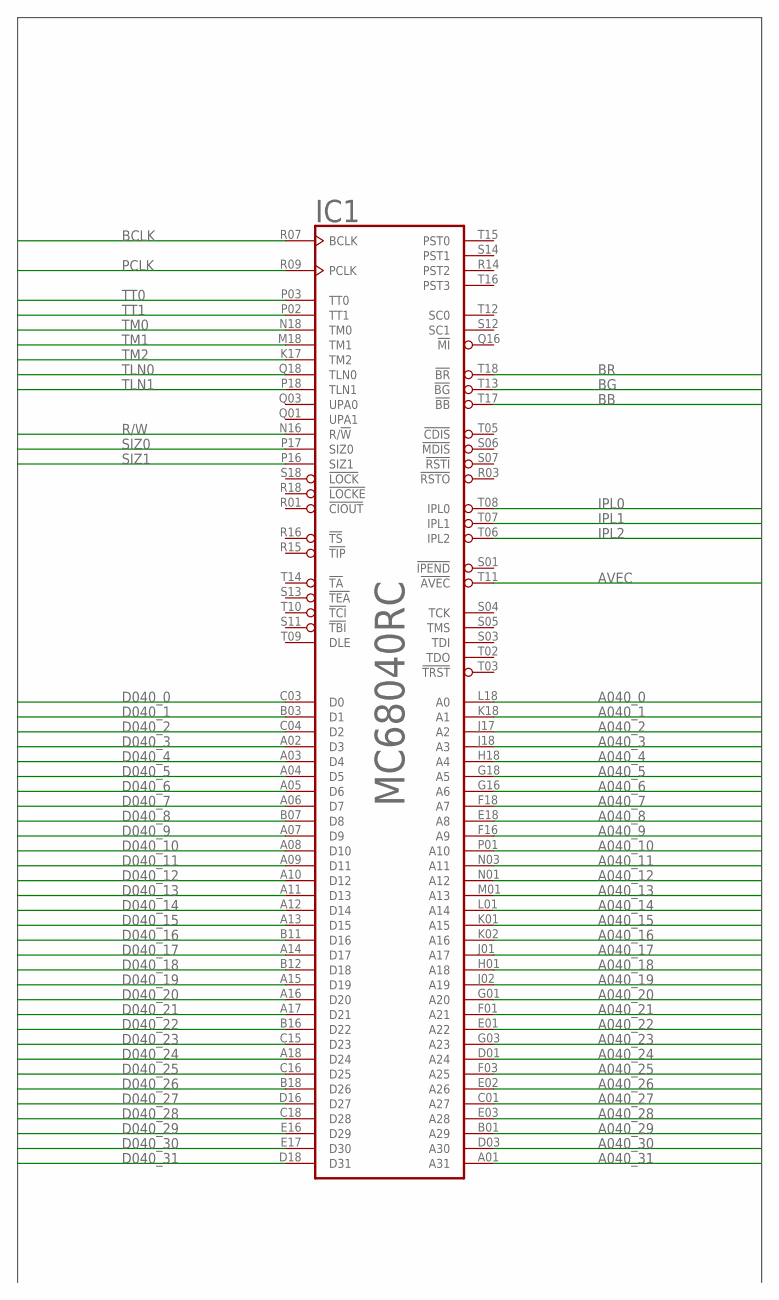
[picture p37: schematic a3640.sch, sheet 1]

Parts:
IC1: MC68040RC; MPGA-179

Connections:
A040_0: IC1.L18 (A0)
A040_1: IC1.K18 (A1)
A040_2: IC1.J17 (A2)
A040_3: IC1.J18 (A3)
A040_4: IC1.H18 (A4)
A040_5: IC1.G18 (A5)
A040_6: IC1.G16 (A6)
A040_7: IC1.F18 (A7)
A040_8: IC1.E18 (A8)
A040_9: IC1.F16 (A9)
A040_10: IC1.P01 (A10)
A040_11: IC1.N03 (A11)
A040_12: IC1.N01 (A12)
A040_13: IC1.M01 (A13)
A040_14: IC1.L01 (A14)
A040_15: IC1.K01 (A15)
A040_16: IC1.K02 (A16)
A040_17: IC1.J01 (A17)
A040_18: IC1.H01 (A18)
A040_19: IC1.J02 (A19)
A040_20: IC1.G01 (A20)
A040_21: IC1.F01 (A21)
A040_22: IC1.E01 (A22)
A040_23: IC1.G03 (A23)
A040_24: IC1.D01 (A24)
A040_25: IC1.F03 (A25)
A040_26: IC1.E02 (A26)
A040_27: IC1.C01 (A27)
A040_28: IC1.E03 (A28)
A040_29: IC1.B01 (A29)
A040_30: IC1.D03 (A30)
A040_31: IC1.A01 (A31)
AVEC: IC1.T11 (!AVEC)
BB: IC1.T17 (!BB)
BCLK: IC1.R07 (BCLK)
BG: IC1.T13 (!BG)
BR: IC1.T18 (!BR)
D040_0: IC1.C03 (D0); also elsewhere on the board
D040_1: IC1.B03 (D1); also elsewhere on the board
D040_2: IC1.C04 (D2); also elsewhere on the board
D040_3: IC1.A02 (D3); also elsewhere on the board
D040_4: IC1.A03 (D4); also elsewhere on the board
D040_5: IC1.A04 (D5); also elsewhere on the board
D040_6: IC1.A05 (D6); also elsewhere on the board
D040_7: IC1.A06 (D7); also elsewhere on the board
D040_8: IC1.B07 (D8); also elsewhere on the board
D040_9: IC1.A07 (D9); also elsewhere on the board
D040_10: IC1.A08 (D10); also elsewhere on the board
D040_11: IC1.A09 (D11); also elsewhere on the board
D040_12: IC1.A10 (D12); also elsewhere on the board
D040_13: IC1.A11 (D13); also elsewhere on the board
D040_14: IC1.A12 (D14); also elsewhere on the board
D040_15: IC1.A13 (D15); also elsewhere on the board
D040_16: IC1.B11 (D16); also elsewhere on the board
D040_17: IC1.A14 (D17); also elsewhere on the board
D040_18: IC1.B12 (D18); also elsewhere on the board
D040_19: IC1.A15 (D19); also elsewhere on the board
D040_20: IC1.A16 (D20); also elsewhere on the board
D040_21: IC1.A17 (D21); also elsewhere on the board
D040_22: IC1.B16 (D22); also elsewhere on the board
D040_23: IC1.C15 (D23); also elsewhere on the board
D040_24: IC1.A18 (D24); also elsewhere on the board
D040_25: IC1.C16 (D25); also elsewhere on the board
D040_26: IC1.B18 (D26); also elsewhere on the board
D040_27: IC1.D16 (D27); also elsewhere on the board
D040_28: IC1.C18 (D28); also elsewhere on the board
D040_29: IC1.E16 (D29); also elsewhere on the board
D040_30: IC1.E17 (D30); also elsewhere on the board
D040_31: IC1.D18 (D31); also elsewhere on the board
GND: IC1.B02 (GND), IC1.B04 (GND), IC1.B06 (GND), IC1.B08 (GND), IC1.B10 (GND), IC1.B13 (GND), IC1.B15 (GND), IC1.B17 (GND), IC1.C06 (GND), IC1.C07 (GND), IC1.C09 (GND), IC1.C11 (GND), IC1.C13 (GND), IC1.D02 (GND), IC1.D17 (GND), IC1.F02 (GND), IC1.F17 (GND), IC1.H02 (GND), IC1.H17 (GND), IC1.K03 (GND), IC1.K16 (GND), IC1.L02 (GND), IC1.L03 (GND), IC1.L17 (GND), IC1.M16 (GND), IC1.N02 (GND), IC1.N17 (GND), IC1.Q02 (GND), IC1.Q17 (GND), IC1.R04 (GND), IC1.R06 (GND), IC1.R10 (GND), IC1.R11 (GND), IC1.R13 (GND), IC1.S02 (GND), IC1.S09 (GND), IC1.S10 (GND), IC1.S15 (GND), IC1.S17 (GND), IC1.T04 (GND); also elsewhere on the board
IPL0: IC1.T08 (IPL0)
IPL1: IC1.T07 (IPL1)
IPL2: IC1.T06 (IPL2)
PCLK: IC1.R09 (PCLK)
R/W: IC1.N16 (R/!W)
SIZ0: IC1.P17 (SIZ0)
SIZ1: IC1.P16 (SIZ1)
TLN0: IC1.Q18 (TLN0)
TLN1: IC1.P18 (TLN1)
TM0: IC1.N18 (TM0)
TM1: IC1.M18 (TM1)
TM2: IC1.K17 (TM2)
TT0: IC1.P03 (TT0)
TT1: IC1.P02 (TT1)
VCC: IC1.B05 (VCC), IC1.B09 (VCC), IC1.B14 (VCC), IC1.C02 (VCC), IC1.C05 (VCC), IC1.C08 (VCC), IC1.C10 (VCC), IC1.C12 (VCC), IC1.C14 (VCC), IC1.C17 (VCC), IC1.G02 (VCC), IC1.G17 (VCC), IC1.H03 (VCC), IC1.H16 (VCC), IC1.J03 (VCC), IC1.J16 (VCC), IC1.L16 (VCC), IC1.M02 (VCC), IC1.M03 (VCC), IC1.M17 (VCC), IC1.R02 (VCC), IC1.R05 (VCC), IC1.R08 (VCC), IC1.R12 (VCC), IC1.R17 (VCC), IC1.S08 (VCC), IC1.S16 (VCC); also elsewhere on the board
