arananet/TF-HARDWARE/a3640/eagle/a3640.brd

## EAGLE design a3640/eagle/a3640.brd (continued)

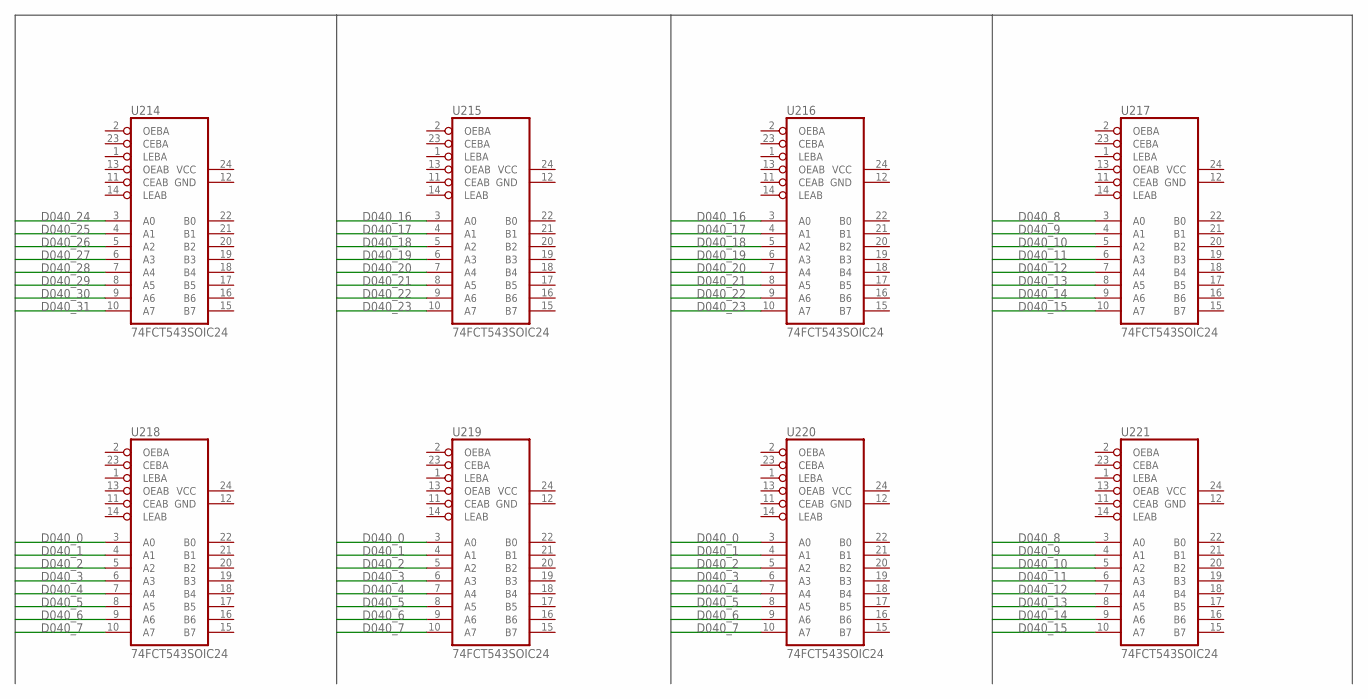
[picture p38: schematic a3640.sch, sheet 2]

Parts:
U214, U215, U216, U217, U218, U219, U220, U221: 74FCT543SOIC24; 74FCT543A

Connections:
D040_0: U218.3 (A0), U219.3 (A0), U220.3 (A0); also elsewhere on the board
D040_1: U218.4 (A1), U219.4 (A1), U220.4 (A1); also elsewhere on the board
D040_2: U218.5 (A2), U219.5 (A2), U220.5 (A2); also elsewhere on the board
D040_3: U218.6 (A3), U219.6 (A3), U220.6 (A3); also elsewhere on the board
D040_4: U218.7 (A4), U219.7 (A4), U220.7 (A4); also elsewhere on the board
D040_5: U218.8 (A5), U219.8 (A5), U220.8 (A5); also elsewhere on the board
D040_6: U218.9 (A6), U219.9 (A6), U220.9 (A6); also elsewhere on the board
D040_7: U218.10 (A7), U219.10 (A7), U220.10 (A7); also elsewhere on the board
D040_8: U217.3 (A0), U221.3 (A0); also elsewhere on the board
D040_9: U217.4 (A1), U221.4 (A1); also elsewhere on the board
D040_10: U217.5 (A2), U221.5 (A2); also elsewhere on the board
D040_11: U217.6 (A3), U221.6 (A3); also elsewhere on the board
D040_12: U217.7 (A4), U221.7 (A4); also elsewhere on the board
D040_13: U217.8 (A5), U221.8 (A5); also elsewhere on the board
D040_14: U217.9 (A6), U221.9 (A6); also elsewhere on the board
D040_15: U217.10 (A7), U221.10 (A7); also elsewhere on the board
D040_16: U215.3 (A0), U216.3 (A0); also elsewhere on the board
D040_17: U215.4 (A1), U216.4 (A1); also elsewhere on the board
D040_18: U215.5 (A2), U216.5 (A2); also elsewhere on the board
D040_19: U215.6 (A3), U216.6 (A3); also elsewhere on the board
D040_20: U215.7 (A4), U216.7 (A4); also elsewhere on the board
D040_21: U215.8 (A5), U216.8 (A5); also elsewhere on the board
D040_22: U215.9 (A6), U216.9 (A6); also elsewhere on the board
D040_23: U215.10 (A7), U216.10 (A7); also elsewhere on the board
D040_24: U214.3 (A0); also elsewhere on the board
D040_25: U214.4 (A1); also elsewhere on the board
D040_26: U214.5 (A2); also elsewhere on the board
D040_27: U214.6 (A3); also elsewhere on the board
D040_28: U214.7 (A4); also elsewhere on the board
D040_29: U214.8 (A5); also elsewhere on the board
D040_30: U214.9 (A6); also elsewhere on the board
D040_31: U214.10 (A7); also elsewhere on the board
GND: U214.12 (GND), U215.12 (GND), U216.12 (GND), U217.12 (GND), U218.12 (GND), U219.12 (GND), U220.12 (GND), U221.12 (GND); also elsewhere on the board
VCC: U214.24 (VCC), U215.24 (VCC), U216.24 (VCC), U217.24 (VCC), U218.24 (VCC), U219.24 (VCC), U220.24 (VCC), U221.24 (VCC); also elsewhere on the board

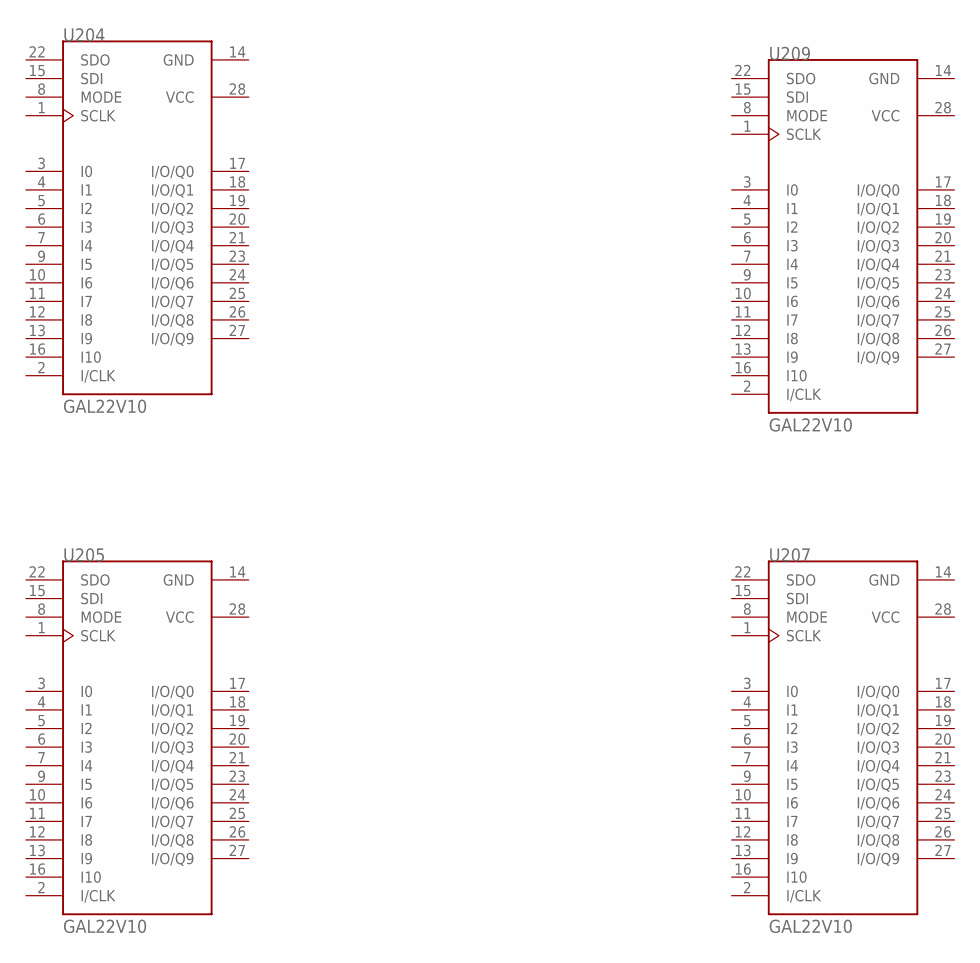
[picture p39: schematic a3640.sch, sheet 3]

Parts:
U204, U205, U207, U209: GAL22V10

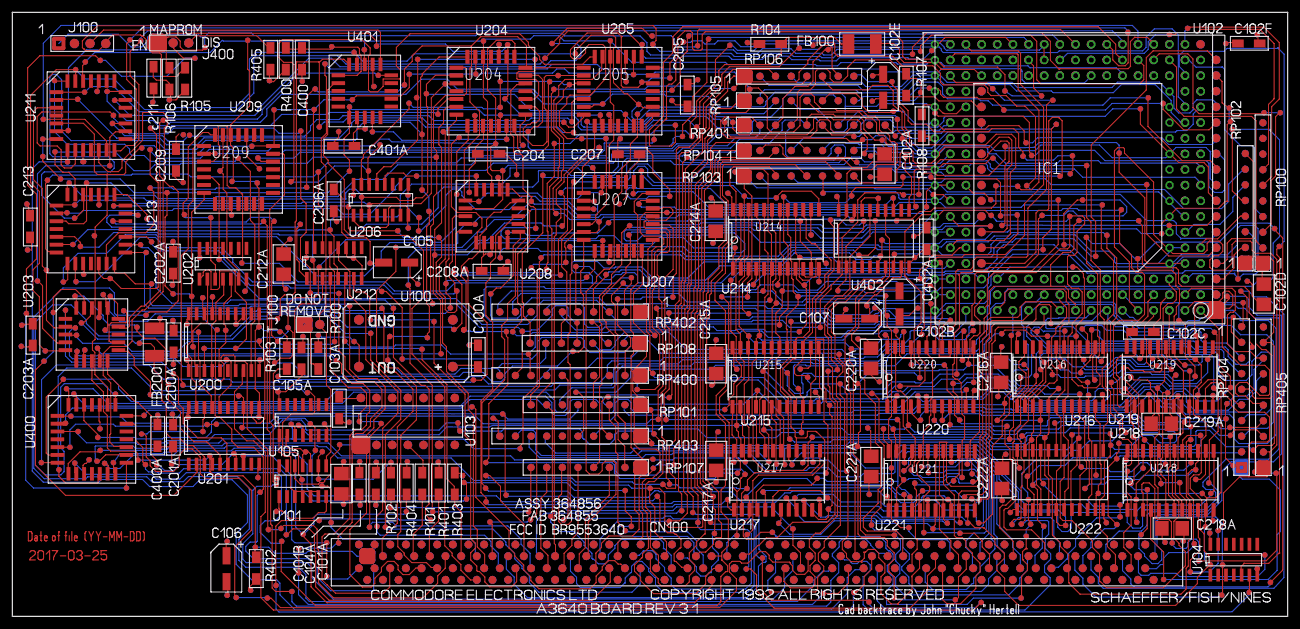
[picture p40: board a3640.brd from above]

Board: 4 copper layers, 207.0 x 98.0 mm, 13 parts (0 on the bottom side), 34 nets.
