arananet/TF-HARDWARE/(commit log)

2017-04-18 Fixed silkscreen
    [SL530.brd, SL530.sch]
2017-04-26 Bit of a clean up of the silkscreen
    [SL530.brd, SL530.sch]
