arananet/TF-HARDWARE/(notices)

Notices in the files:
breakout/tools/54600.py:
This program is free software: you can redistribute it and/or modify it under
the terms of the GNU General Public License as published by the Free Software
tf530/ucf/tf530_ram_control_rev3.ucf:
TF530 is free software: you can redistribute it and/or modify
it under the terms of the GNU General Public License as published by
the Free Software Foundation, either version 3 of the License, or
(at your option) any later version.
breakout/68030/eagle/breakout.brd:
(C) 2016 S.J.Leary
tf520/eagle/tf520.brd:
Published under the GNU Public License (GPL) v2
breakout/cd32/eagle/cd32.brd:
(C) 2017 S.J Leary
Publushed Under the GNU GPLv2
breakout/68kshunt/eagle/68kshunt.brd:
Published Under the GNU GPL v2
breakout/68020/eagle/breakout.brd:
(C) 2016-2017 S.J.Leary
parts and their libraries:
microbuilder: This work is placed in the public domain, and may be freely used for commercial and non-commercial work with the following conditions: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
SparkFun-Retired: Licensing:Creative Commons ShareAlike 4.0 International - https://creativecommons.org/licenses/by-sa/4.0
