arananet/TF-HARDWARE/tf530/docs/IMG_5832.JPG

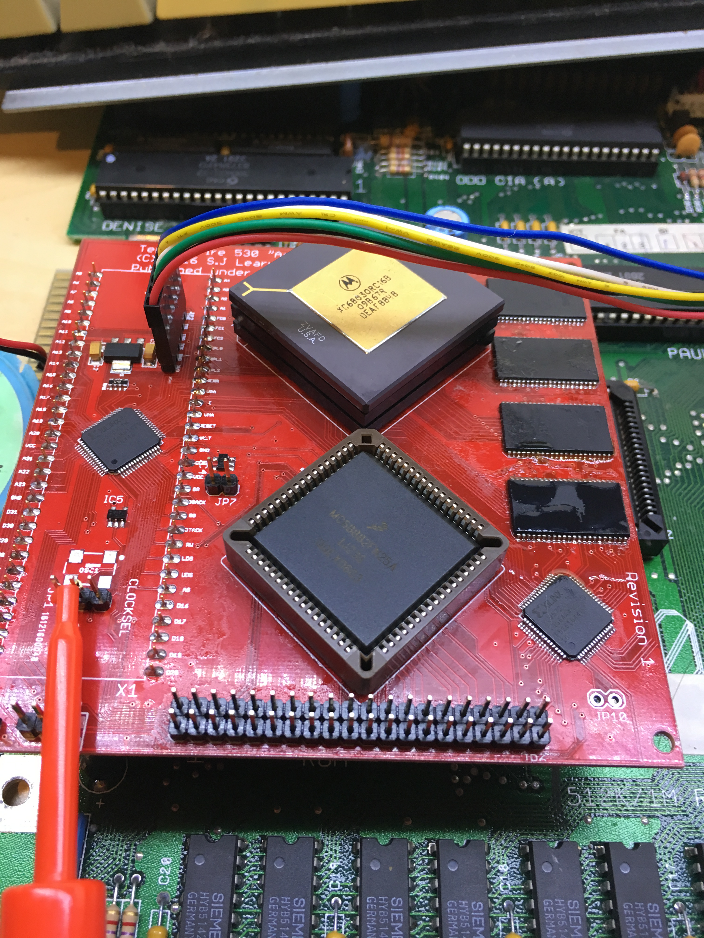
tf530/docs/IMG_5832.JPG
