arananet/TF-HARDWARE/tf530/docs/IMG_5966.JPG

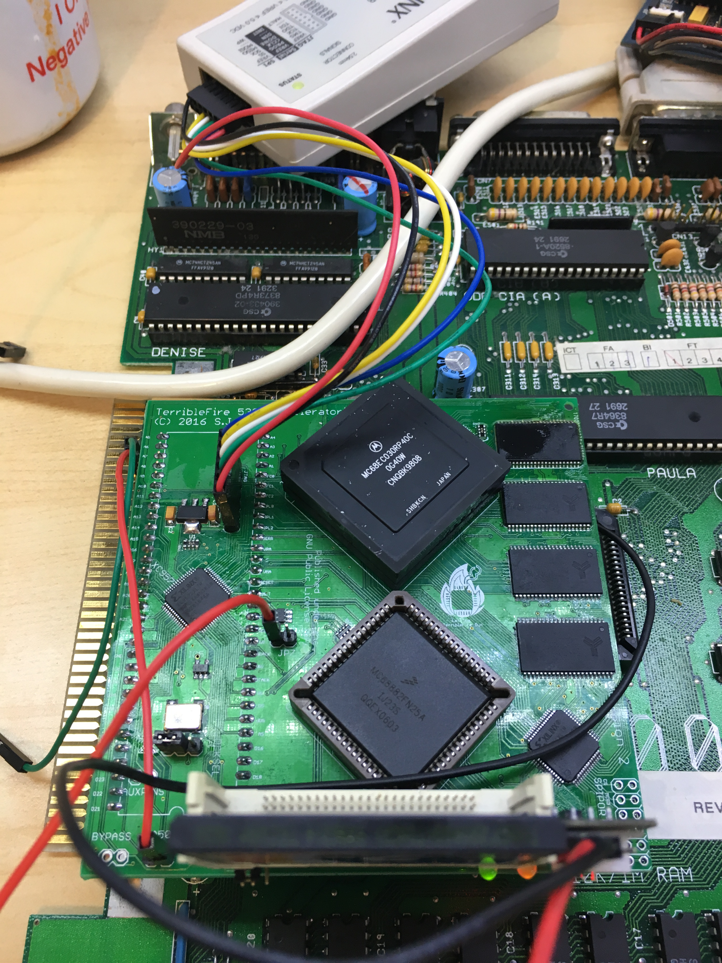
tf530/docs/IMG_5966.JPG
